rat0mu/2026-Rocket-Taiwan-Cup/avionics/hardware/pcb/台灣盃航電艙第2層_通訊/production/bom.csv

Designator | Footprint | Quantity | Value | LCSC Part #
BT1 | BatteryHolder_Keystone_3000_1x12mm | 1 | Coin_Cell
C1 | 0201 | 1 | 100n
C12, C15, C2, C3 | 0603 | 4 | 100n
C13, C9 | 0402 | 2 | NC
C14 | 0805 | 1 | 10u
C22, C24 | 0402 | 2 | 100n
C23, C25 | 0603 | 2 | 10u
C4 | 0603 | 1 | 1u
C5 | 0201 | 1 | 47p
C6 | 0201 | 1 | 1u
D1 | D_SOD-123 | 1 | 0.5A/40V/420mV
FB1 | 0603 | 1 | FerriteBead
J1, J2 | SMA_Amphenol_132134-11_Vertical | 2 | SMA
R1, R2, R3, R4 | 0603 | 4 | 4.7k
R5 | 0603 | 1 | 100k
R6 | 0603 | 1 | 1k
R7 | 0603 | 1 | 33R
R8 | 0402 | 1 | 0
R9 | 0603 | 1 | 10k
TP1 | TestPoint_Pad_1.0x1.0mm | 1 | Test Point
U1 | LGA-12_2x2mm_P0.5mm | 1 | LIS3MDL
U2 | ublox_NEO | 1 | NEO-M9N
U3 | PE22-230T22S | 1 | E22-900T22S
U5 | PinHeader_2x20_P2.54mm_Vertical | 1 | Connector
