rat0mu/2026-Rocket-Taiwan-Cup/avionics/hardware/pcb/台灣盃航電艙第3層_主系統/production/bom.csv

Designator | Footprint | Quantity | Value | LCSC Part #
C1, C2 | 0603 | 2 | 18p
C10, C11, C12, C13, C14, C15, C16, C17, C19, C20, C21, C22, C25, C28, C4, C5, C8 | 0603 | 17 | 100n
C18, C29 | 0805 | 2 | 10u
C3, C9 | 0603 | 2 | 1u
C30, C32 | 0402 | 2 | 100n
C31, C33 | 0603 | 2 | 10u
C6, C7 | 0805 | 2 | 2.2u
D1 | 0805 | 1 | LED
FB1 | 0603 | 1 | bead
J1 | JST_XH_S2B-XH-A_1x02_P2.50mm_Horizontal | 1 | ~
J2 | microSD_HC_Hirose_DM3D-SF | 1 | Micro_SD_Card_Det2
J3 | PinHeader_1x04_P2.54mm_Horizontal | 1 | Conn_01x04_Pin
R1 | 0603 | 1 | 0
R2, R3, R5, R6, R7, R8, R9 | 0603 | 7 | 10k
R4 | 0805 | 1 | 510
SW1 | SW_SPST_FSMSM | 1 | SW_SPST
U1 | LQFP-100_14x14mm_P0.5mm | 1 | STM32F405VGT6
U11 | PinHeader_2x20_P2.54mm_Vertical | 1 | Connector
U2 | PQFN50P450X300X100-16N | 1 | BMI088
U3 | XDCR_BMP390L | 1 | BMP388
U5 | QFN300X300X100-16N | 1 | H3LIS331DL
Y1 | Crystal_SMD_3225-4Pin_3.2x2.5mm | 1 | 16MHz
