rat0mu/2026-Rocket-Taiwan-Cup/avionics/hardware/pcb/台灣盃航電艙第4層_供電/production/bom.csv

Designator | Footprint | Quantity | Value | LCSC Part #
C1, C2 | CP_Elec_10x10 | 2 | 680u
C10, C5, C6, C9 | 0805 | 4 | 10u
C11, C12, C7, C8 | 0603 | 4 | 100n
C3, C4 | CP_Elec_8x10 | 2 | 220u
D1, D2 | D_SMC | 2 | 1N5824
D3, D4 | 0805 | 2 | LED
D5 | D_SOD-123 | 1 | D_M1
D6 | D_SOD-123 | 1 | D_B1
D7 | D_SOD-123 | 1 | D_M2
D8 | D_SOD-123 | 1 | D_B2
J1, J2 | AMASS_XT60PW-M_1x02_P7.20mm_Horizontal | 2 | XT60
J3 | JST_XH_S6B-XH-A_1x06_P2.50mm_Horizontal | 1 | Conn_01x06_Pin
L1, L2 | L_APV_ANR6045 | 2 | 33u
PYRO1 | JST_XH_S2B-XH-A_1x02_P2.50mm_Horizontal | 1 | Pyro1
PYRO2 | JST_XH_S2B-XH-A_1x02_P2.50mm_Horizontal | 1 | Pyro2
Q1, Q2, Q3, Q4 | SOT-223 | 4 | NMOS
R10, R11, R13, R14 | 0805 | 4 | 220
R12, R15 | 0805 | 2 | 2.2k
U11 | PinHeader_2x20_P2.54mm_Vertical | 1 | Connector
U3, U4 | TO-263-5_TabPin3 | 2 | LM2596S-5
U5, U6 | SOT-223-3_TabPin2 | 2 | AMS1117-3.3
