rat0mu/2026-Rocket-Taiwan-Cup/avionics/hardware/pcb/台灣盃航電艙第5層_次系統/production/bom.csv

Designator | Footprint | Quantity | Value | LCSC Part #
BT1 | BatteryHolder_Keystone_3000_1x12mm | 1 | Coin_Cell
C1, C2 | 0201 | 2 | 12p
C10, C12, C13, C19, C22, C6 | 0603 | 6 | 100n
C11 | 0603 | 1 | 10u
C16 | 0201 | 1 | 47p
C17 | 0201 | 1 | 1u
C18, C20 | 0402 | 2 | NC
C21 | 0805 | 1 | 10u
C23, C4, C5, C7, C8 | 0402 | 5 | 100n
C3 | 0603 | 1 | 1u
C9 | 0201 | 1 | 100n
D1 | 0201 | 1 | LED
D2 | D_SOD-123 | 1 | 0.5A/40V/420mV
FB1 | 0603 | 1 | FerriteBead
J1 | JST_XH_S2B-XH-A_1x02_P2.50mm_Horizontal | 1 | SH 1.0
J2 | microSD_HC_Hirose_DM3D-SF | 1 | Micro_SD_Card
J3, J4 | SMA_Amphenol_132134-11_Vertical | 2 | SMA
J5 | PinHeader_1x04_P2.54mm_Horizontal | 1 | Conn_01x04_Pin
J6 | JST_XH_S6B-XH-A_1x06_P2.50mm_Horizontal | 1 | Conn_01x06_Pin
R1 | 0603 | 1 | 0
R10 | 0603 | 1 | 33R
R11 | 0402 | 1 | 0
R12, R2 | 0603 | 2 | 10k
R3 | 0603 | 1 | 510
R4, R5, R6, R7 | 0603 | 4 | 4.7k
R8 | 0603 | 1 | 100k
R9 | 0603 | 1 | 1k
SW2 | SW_SPST_FSMSM | 1 | SW_SPST
TP1 | TestPoint_Pad_1.0x1.0mm | 1 | Test Point
U1 | LQFP-48_7x7mm_P0.5mm | 1 | STM32F103C8Tx
U2 | XDCR_BMP390L | 1 | BMP390L
U3 | ublox_NEO | 1 | NEO-M9N
U6 | PE22-230T22S | 1 | E22-400T22S
Y1 | Crystal_SMD_3225-4Pin_3.2x2.5mm | 1 | 8MHz
