rat0mu/2026-Rocket-Taiwan-Cup/avionics/hardware/pcb/台灣盃航電艙第1層_聲學實驗/production/First_Layer_bom.csv

Designator | Footprint | Quantity | Value | LCSC Part #
C1 | 0603 | 1 | 2.2u
C10 | 0402 | 1 | 220p
C11 | 0603 | 1 | 4.7u
C12, C14, C16, C17, C19, C2, C20, C22, C23, C25 | 0402 | 10 | 0.1u
C13 | 0805 | 1 | 22u
C15, C7, C8, C9 | 0603 | 4 | 10u
C18, C21, C24, C6 | 0402 | 4 | 1u
C3, C4, C5 | 0402 | 3 | 100n
D1 | D_SOD-123 | 1 | MBR0520
FB1 | 0603 | 1 | FerriteBead
L1 | 1206 | 1 | 10u
R1, R5, R6, R7 | 0603 | 4 | 2k
R2 | 0603 | 1 | 51K
R3 | 0603 | 1 | 24.9K
R4 | 0603 | 1 | 178K
U1, U4, U7, U9 | XDCR_MPXV2202DPT1 | 4 | MPXV2202DPT1
U10, U2, U6, U8 | VSSOP-8_3x3mm_P0.65mm | 4 | INA333xxDGK
U3 | SOT-23-5 | 1 | LM2733YMF
U5 | PinHeader_2x20_P2.54mm_Vertical | 1 | Connector
