rat0mu/2026-Rocket-Taiwan-Cup/structure/cad/airframe/avionics_bay/avionic_bay.SLDASM

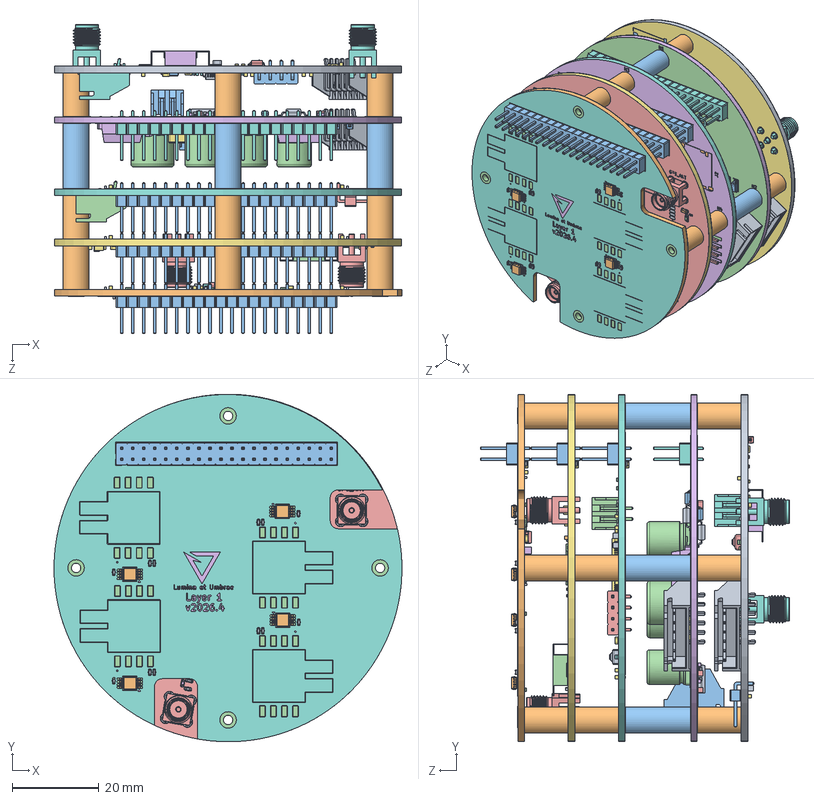
[picture p1: CAD file, 2026-05-14]
structure/cad/airframe/avionics_bay/avionic_bay.SLDASM
80.1 x 80.0 x 71.2 mm
C_0402_1005Metric x 24
VSSOP-8_3x3mm_P0.65mm x 4
PinHeader_2x20_P2.54mm_Vertical x 3
R_0603_1608Metric x 22
SOT-23-5
L_1206_3216Metric
C_0603_1608Metric x 37
D_SOD-123 x 2
C_0805_2012Metric x 6
L_0603_1608Metric x 3
疇_簞癟_瞿癟__癡_穠矇_罈疇__矇_竅癡翹_疇簣瞻_copper
疇_簞癟_瞿癟__癡_穠矇_罈疇__矇_竅癡翹_疇簣瞻_pad
疇_簞癟_瞿癟__癡_穠矇_罈疇__矇_竅癡翹_疇簣瞻_via
疇_簞癟_瞿癟__癡_穠矇_罈疇__矇_竅癡翹_疇簣瞻_silkscreen
疇_簞癟_瞿癟__癡_穠矇_罈疇__矇_竅癡翹_疇簣瞻_silkscreen_2
疇_簞癟_瞿癟__癡_穠矇_罈疇__矇_竅癡翹_疇簣瞻_soldermask
疇_簞癟_瞿癟__癡_穠矇_罈疇__矇_竅癡翹_疇簣瞻_soldermask_2
疇_簞癟_瞿癟__癡_穠矇_罈疇__矇_竅癡翹_疇簣瞻_PCB
C_0201_0603Metric x 3
BatteryHolder_Keystone_3000_1x12mm
SMA_Amphenol_132134-11_Vertical x 2
R_0402_1005Metric
LGA-12_2x2mm_P0.5mm
疇_簞癟_瞿癟__癡_穠矇_罈疇__瓣繡_疇簣瞻_copper
疇_簞癟_瞿癟__癡_穠矇_罈疇__瓣繡_疇簣瞻_pad
疇_簞癟_瞿癟__癡_穠矇_罈疇__瓣繡_疇簣瞻_via
疇_簞癟_瞿癟__癡_穠矇_罈疇__瓣繡_疇簣瞻_silkscreen
疇_簞癟_瞿癟__癡_穠矇_罈疇__瓣繡_疇簣瞻_silkscreen_2
疇_簞癟_瞿癟__癡_穠矇_罈疇__瓣繡_疇簣瞻_soldermask
疇_簞癟_瞿癟__癡_穠矇_罈疇__瓣繡_疇簣瞻_soldermask_2
疇_簞癟_瞿癟__癡_穠矇_罈疇__瓣繡_疇簣瞻_PCB
pines
cuerpo
boton
R_0805_2012Metric
JST_XH_S2B-XH-A_1x02_P2.50mm_Horizontal
PinHeader_1x04_P2.54mm_Horizontal
Crystal_SMD_3225-4Pin_3.2x2.5mm
LQFP-100_14x14mm_P0.5mm
LED_0805_2012Metric
疇_簞癟_瞿癟__癡_穠矇_罈癡__瓣繡簫疇簣瞻_copper
疇_簞癟_瞿癟__癡_穠矇_罈癡__瓣繡簫疇簣瞻_pad
疇_簞癟_瞿癟__癡_穠矇_罈癡__瓣繡簫疇簣瞻_via
疇_簞癟_瞿癟__癡_穠矇_罈癡__瓣繡簫疇簣瞻_silkscreen
疇_簞癟_瞿癟__癡_穠矇_罈癡__瓣繡簫疇簣瞻_silkscreen_2
疇_簞癟_瞿癟__癡_穠矇_罈癡__瓣繡簫疇簣瞻_soldermask
疇_簞癟_瞿癟__癡_穠矇_罈癡__瓣繡簫疇簣瞻_soldermask_2
疇_簞癟_瞿癟__癡_穠矇_罈癡__瓣繡簫疇簣瞻_PCB
複製 of SOT-223^台灣盃航電倉下層 x 6
複製 of R_0805_2012Metric^台灣盃航電倉下層 x 6
複製 of D_SOD-123^台灣盃航電倉下層 x 4
複製 of CP_Elec_10x10^台灣盃航電倉下層 x 2
複製 of D_SMC^台灣盃航電倉下層 x 2
複製 of ________ 1.10.1^複製 of TO-263-5_TabPin3_台灣盃航電倉下層 x 2
複製 of L_APV_ANR6045^台灣盃航電倉下層 x 2
複製 of PinHeader_2x20_P2.54mm_Vertical^台灣盃航電倉下層
複製 of JST_XH_S6B-XH-A_1x06_P2.50mm_Horizontal^台灣盃航電倉下層
複製 of LED_0805_2012Metric^台灣盃航電倉下層 x 2
複製 of JST_XH_S2B-XH-A_1x02_P2.50mm_Horizontal^台灣盃航電倉下層 x 2
複製 of CP_Elec_8x10^台灣盃航電倉下層 x 2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
