rat0mu/2026-Rocket-Taiwan-Cup/structure/cad/airframe/avionics_bay/cylinder15mm.SLDPRT

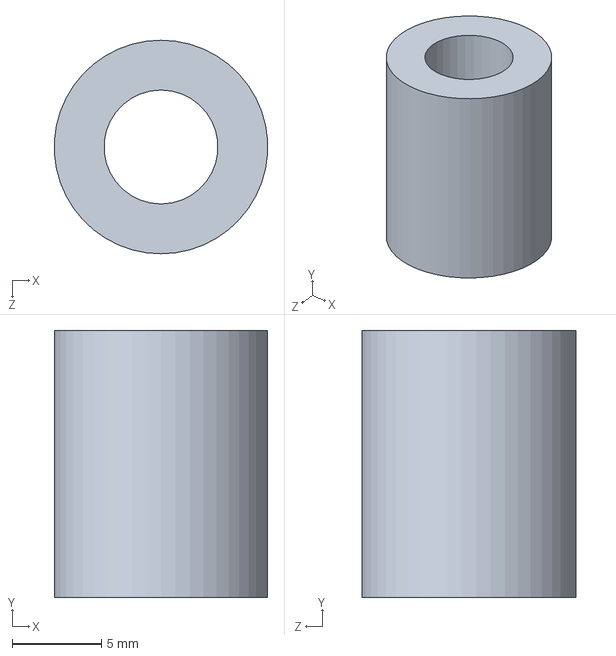
[picture p2: CAD file, 2026-05-14]
structure/cad/airframe/avionics_bay/cylinder15mm.SLDPRT
12.0 x 15.0 x 12.0 mm
