rat0mu/2026-Rocket-Taiwan-Cup/structure/cad/airframe/avionics_bay/support cylinder.SLDPRT

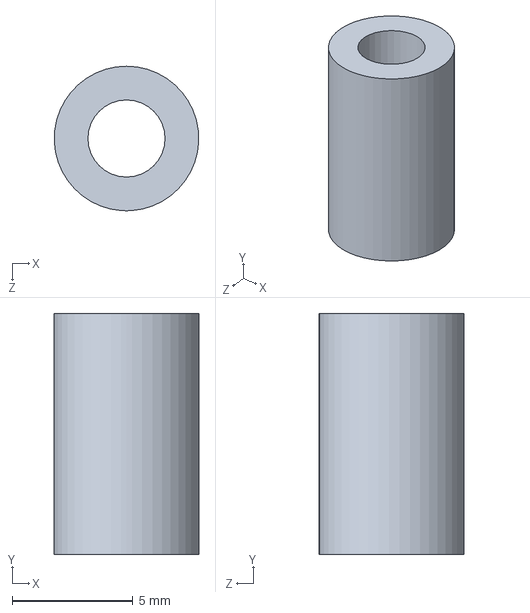
[picture p3: CAD file, 2026-05-14]
structure/cad/airframe/avionics_bay/support cylinder.SLDPRT
6.00 x 10.0 x 6.00 mm
