rat0mu/2026-Rocket-Taiwan-Cup/structure/cad/airframe/avionics_bay/台灣盃航電倉酬載層/台灣盃航電倉酬載層.step

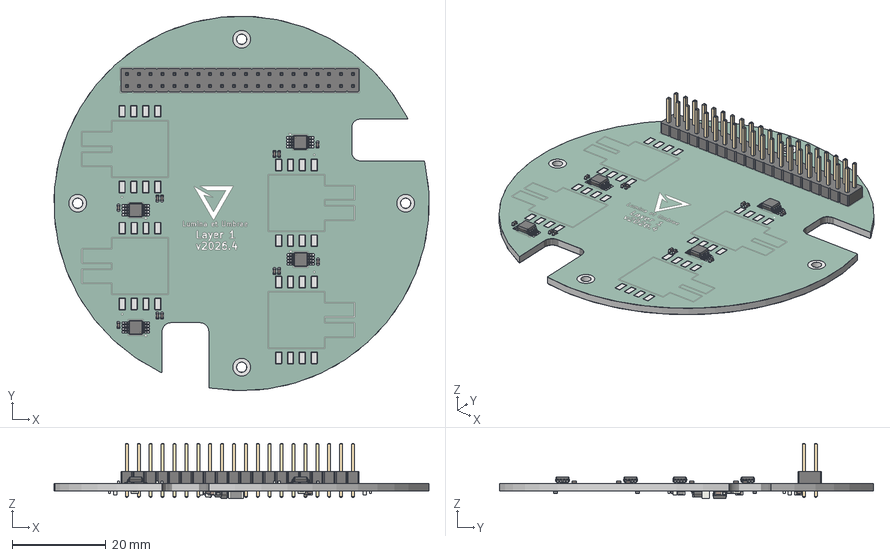
[picture p4: CAD file, 2026-05-14]
structure/cad/airframe/avionics_bay/台灣盃航電倉酬載層/台灣盃航電倉酬載層.step
80.0 x 79.9 x 11.8 mm
C_0402_1005Metric x 18
VSSOP-8_3x3mm_P0.65mm x 4
PinHeader_2x20_P2.54mm_Vertical
R_0603_1608Metric x 7
SOT-23-5
L_1206_3216Metric
C_0603_1608Metric x 6
D_SOD-123
C_0805_2012Metric
L_0603_1608Metric
å°ç£çèªé»åé ¬è¼å±¤_copper
å°ç£çèªé»åé ¬è¼å±¤_pad
å°ç£çèªé»åé ¬è¼å±¤_via
å°ç£çèªé»åé ¬è¼å±¤_silkscreen x 2
å°ç£çèªé»åé ¬è¼å±¤_soldermask x 2
å°ç£çèªé»åé ¬è¼å±¤_PCB
