rat0mu/2026-Rocket-Taiwan-Cup/structure/cad/airframe/avionics_bay/台灣盃航電倉次系統/台灣盃航電倉次系統.step

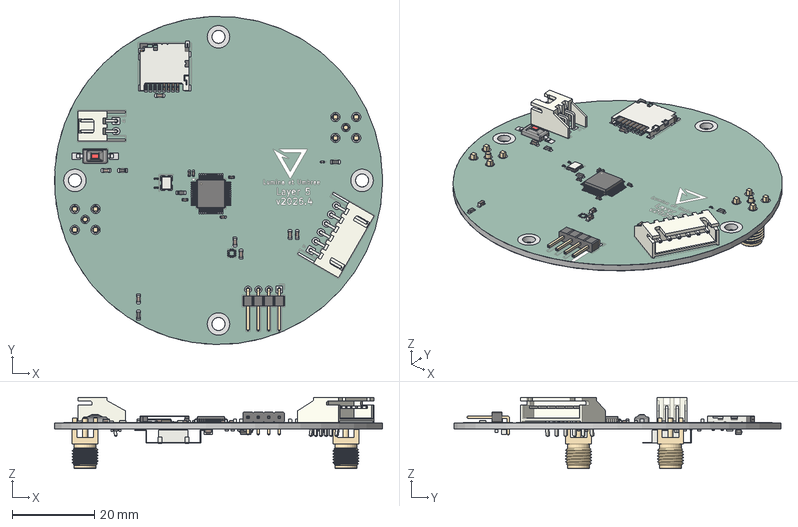
[picture p5: CAD file, 2026-05-14]
structure/cad/airframe/avionics_bay/台灣盃航電倉次系統/台灣盃航電倉次系統.step
80.0 x 80.0 x 17.3 mm
C_0603_1608Metric x 8
C_0402_1005Metric x 7
JST_XH_S6B-XH-A_1x06_P2.50mm_Horizontal
C_0201_0603Metric x 5
Crystal_SMD_3225-4Pin_3.2x2.5mm
pines
cuerpo
boton
R_0603_1608Metric x 11
JST_XH_S2B-XH-A_1x02_P2.50mm_Horizontal
LQFP-48_7x7mm_P0.5mm
microSD_HC_Hirose_DM3D-SF
LED_0201_0603Metric
PinHeader_1x04_P2.54mm_Horizontal
R_0402_1005Metric
D_SOD-123
BatteryHolder_Keystone_3000_1x12mm
L_0603_1608Metric
SMA_Amphenol_132134-11_Vertical x 2
C_0805_2012Metric
å°ç£çèªé»åæ¬¡ç³»çµ±_copper
å°ç£çèªé»åæ¬¡ç³»çµ±_pad
å°ç£çèªé»åæ¬¡ç³»çµ±_via
å°ç£çèªé»åæ¬¡ç³»çµ±_silkscreen x 2
å°ç£çèªé»åæ¬¡ç³»çµ±_soldermask x 2
å°ç£çèªé»åæ¬¡ç³»çµ±_PCB
