rat0mu/2026-Rocket-Taiwan-Cup/structure/cad/airframe/avionics_bay/台灣盃航電艙中層/台灣盃航電艙中層.step

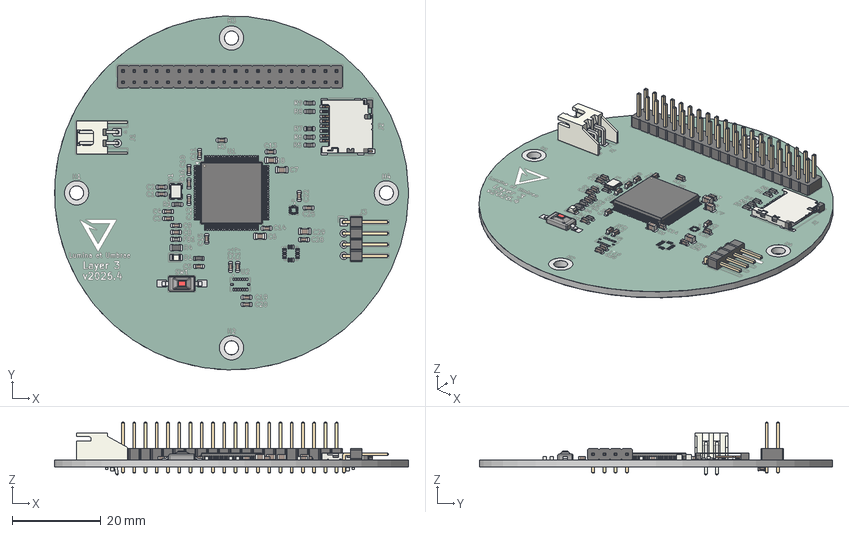
[picture p6: CAD file, 2026-05-14]
structure/cad/airframe/avionics_bay/台灣盃航電艙中層/台灣盃航電艙中層.step
80.0 x 80.0 x 11.9 mm
microSD_HC_Hirose_DM3D-SF
C_0603_1608Metric x 24
C_0805_2012Metric x 4
R_0603_1608Metric x 7
pines
cuerpo
boton
R_0805_2012Metric
JST_XH_S2B-XH-A_1x02_P2.50mm_Horizontal
PinHeader_1x04_P2.54mm_Horizontal
Crystal_SMD_3225-4Pin_3.2x2.5mm
L_0603_1608Metric
PinHeader_2x20_P2.54mm_Vertical
LQFP-100_14x14mm_P0.5mm
LED_0805_2012Metric
C_0402_1005Metric x 2
å°ç£çèªé»èä¸å±¤_copper
å°ç£çèªé»èä¸å±¤_pad
å°ç£çèªé»èä¸å±¤_via
å°ç£çèªé»èä¸å±¤_silkscreen x 2
å°ç£çèªé»èä¸å±¤_soldermask x 2
å°ç£çèªé»èä¸å±¤_PCB
