rat0mu/2026-Rocket-Taiwan-Cup/structure/cad/airframe/avionics_bay/台灣盃航電倉上層/台灣盃航電倉上層.step

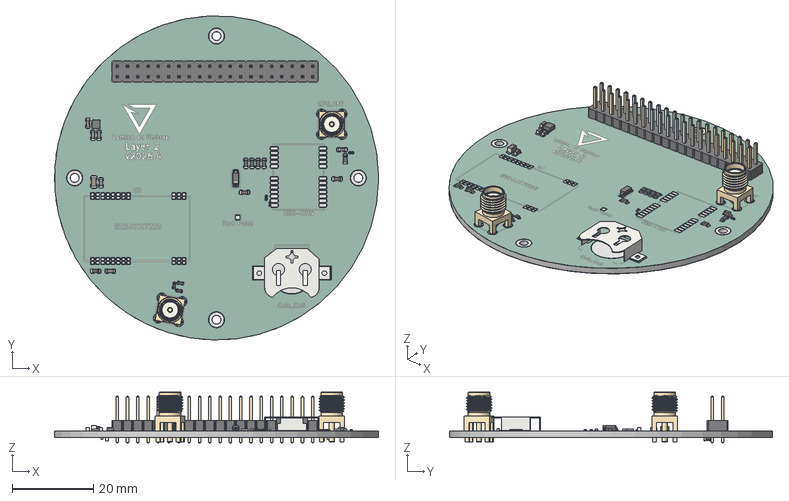
[picture p7: CAD file, 2026-05-14]
structure/cad/airframe/avionics_bay/台灣盃航電倉上層/台灣盃航電倉上層.step
80.0 x 80.0 x 12.6 mm
C_0201_0603Metric x 3
C_0603_1608Metric x 7
C_0402_1005Metric x 4
R_0603_1608Metric x 8
BatteryHolder_Keystone_3000_1x12mm
SMA_Amphenol_132134-11_Vertical x 2
L_0603_1608Metric
R_0402_1005Metric
LGA-12_2x2mm_P0.5mm
C_0805_2012Metric
PinHeader_2x20_P2.54mm_Vertical
D_SOD-123
å°ç£çèªé»åä¸å±¤_copper
å°ç£çèªé»åä¸å±¤_pad
å°ç£çèªé»åä¸å±¤_via
å°ç£çèªé»åä¸å±¤_silkscreen x 2
å°ç£çèªé»åä¸å±¤_soldermask x 2
å°ç£çèªé»åä¸å±¤_PCB
