rat0mu/2026-Rocket-Taiwan-Cup/structure/cad/airframe/avionics_bay/台灣盃航電倉下層/台灣盃航電倉下層.step

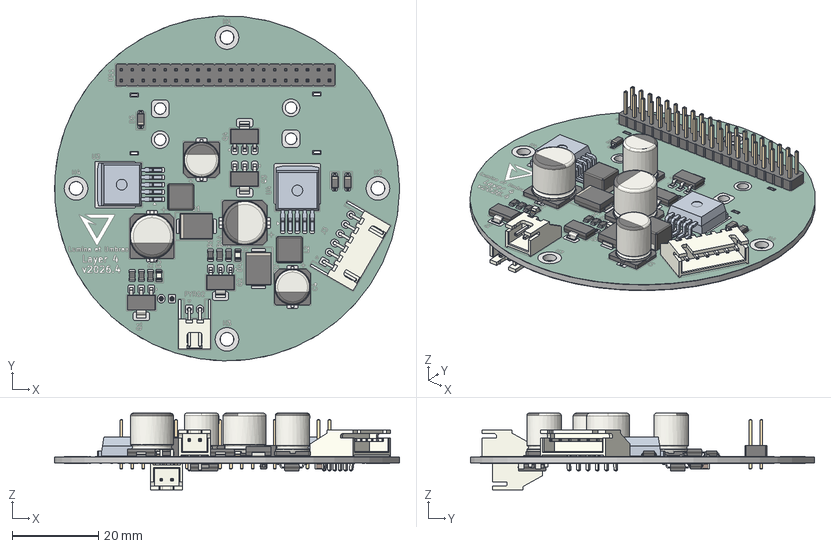
[picture p8: CAD file, 2026-05-14]
structure/cad/airframe/avionics_bay/台灣盃航電倉下層/台灣盃航電倉下層.step
80.0 x 80.0 x 17.8 mm
SOT-223 x 6
R_0805_2012Metric x 6
D_SOD-123 x 4
CP_Elec_10x10 x 2
D_SMC x 2
L_APV_ANR6045 x 2
PinHeader_2x20_P2.54mm_Vertical
JST_XH_S6B-XH-A_1x06_P2.50mm_Horizontal
LED_0805_2012Metric x 2
JST_XH_S2B-XH-A_1x02_P2.50mm_Horizontal x 2
CP_Elec_8x10 x 2
C_0805_2012Metric x 4
C_0603_1608Metric x 4
å°ç£çèªé»åä¸å±¤_copper
å°ç£çèªé»åä¸å±¤_pad
å°ç£çèªé»åä¸å±¤_via
å°ç£çèªé»åä¸å±¤_silkscreen x 2
å°ç£çèªé»åä¸å±¤_soldermask x 2
å°ç£çèªé»åä¸å±¤_PCB
