rat0mu/2026-Rocket-Taiwan-Cup/(list of files, cad)

Other CAD files:
structure/cad/airframe/avionics_bay/台灣盃航電倉下層/TO-263-5_TabPin3.sldasm
structure/cad/airframe/avionics_bay/台灣盃航電艙中層/SW_SPST_FSMSM.sldasm
structure/cad/airframe/avionics_bay/台灣盃航電倉次系統/SW_SPST_FSMSM.sldasm
structure/cad/airframe/avionics_bay/台灣盃航電倉上層/PinHeader_2x20_P2.54mm_Vertical.sldprt
structure/cad/airframe/avionics_bay/台灣盃航電倉下層/疇_簞癟_瞿癟__癡_穠矇_罈疇__瓣繡_疇簣瞻_pad.sldprt
structure/cad/airframe/avionics_bay/台灣盃航電倉次系統/D_SOD-123.sldprt
structure/cad/airframe/avionics_bay/台灣盃航電倉酬載層/VSSOP-8_3x3mm_P0.65mm.sldprt
structure/cad/airframe/avionics_bay/台灣盃航電艙中層/LQFP-100_14x14mm_P0.5mm.sldprt
structure/cad/airframe/avionics_bay/台灣盃航電倉上層/疇_簞癟_瞿癟__癡_穠矇_罈疇__瓣繡_疇簣瞻_copper.sldprt
structure/cad/airframe/avionics_bay/台灣盃航電倉下層/疇_簞癟_瞿癟__癡_穠矇_罈疇__瓣繡_疇簣瞻_via.sldprt
structure/cad/airframe/avionics_bay/台灣盃航電倉次系統/C_0805_2012Metric.sldprt
structure/cad/airframe/avionics_bay/台灣盃航電倉酬載層/疇_簞癟_瞿癟__癡_穠矇_罈疇__矇_竅癡翹_疇簣瞻_soldermask_2.sldprt
structure/cad/airframe/avionics_bay/台灣盃航電艙中層/C_0805_2012Metric.sldprt
structure/cad/airframe/avionics_bay/台灣盃航電倉上層/D_SOD-123.sldprt
structure/cad/airframe/avionics_bay/台灣盃航電倉下層/疇_簞癟_瞿癟__癡_穠矇_罈疇__瓣繡_疇簣瞻_copper.sldprt
structure/cad/airframe/avionics_bay/台灣盃航電倉次系統/疇_簞癟_瞿癟__癡_穠矇_罈疇__疆竅癒癟糧罈癟繕簣_silkscreen.sldprt
structure/cad/airframe/avionics_bay/台灣盃航電倉酬載層/SOT-23-5.sldprt
structure/cad/airframe/avionics_bay/台灣盃航電艙中層/PinHeader_1x04_P2.54mm_Horizontal.sldprt
structure/cad/airframe/avionics_bay/台灣盃航電倉上層/疇_簞癟_瞿癟__癡_穠矇_罈疇__瓣繡_疇簣瞻_soldermask.sldprt
structure/cad/airframe/avionics_bay/台灣盃航電倉次系統/C_0402_1005Metric.sldprt
structure/cad/airframe/avionics_bay/台灣盃航電倉酬載層/C_0603_1608Metric.sldprt
structure/cad/airframe/avionics_bay/台灣盃航電艙中層/boton.sldprt
structure/cad/airframe/avionics_bay/台灣盃航電倉上層/疇_簞癟_瞿癟__癡_穠矇_罈疇__瓣繡_疇簣瞻_via.sldprt
structure/cad/airframe/avionics_bay/台灣盃航電倉下層/CP_Elec_8x10.sldprt
structure/cad/airframe/avionics_bay/台灣盃航電倉次系統/SMA_Amphenol_132134-11_Vertical.sldprt
structure/cad/airframe/avionics_bay/台灣盃航電倉酬載層/疇_簞癟_瞿癟__癡_穠矇_罈疇__矇_竅癡翹_疇簣瞻_soldermask.sldprt
structure/cad/airframe/avionics_bay/台灣盃航電艙中層/PinHeader_2x20_P2.54mm_Vertical.sldprt
structure/cad/airframe/avionics_bay/台灣盃航電倉上層/C_0201_0603Metric.sldprt
structure/cad/airframe/avionics_bay/台灣盃航電倉下層/R_0805_2012Metric.sldprt
structure/cad/airframe/avionics_bay/台灣盃航電倉次系統/PinHeader_1x04_P2.54mm_Horizontal.sldprt
structure/cad/airframe/avionics_bay/台灣盃航電倉酬載層/疇_簞癟_瞿癟__癡_穠矇_罈疇__矇_竅癡翹_疇簣瞻_pad.sldprt
structure/cad/airframe/avionics_bay/台灣盃航電艙中層/疇_簞癟_瞿癟__癡_穠矇_罈癡__瓣繡簫疇簣瞻_silkscreen.sldprt
structure/cad/airframe/avionics_bay/台灣盃航電倉上層/SMA_Amphenol_132134-11_Vertical.sldprt
structure/cad/airframe/avionics_bay/台灣盃航電倉下層/C_0805_2012Metric.sldprt
structure/cad/airframe/avionics_bay/台灣盃航電倉次系統/R_0603_1608Metric.sldprt
structure/cad/airframe/avionics_bay/台灣盃航電倉酬載層/疇_簞癟_瞿癟__癡_穠矇_罈疇__矇_竅癡翹_疇簣瞻_PCB.sldprt
structure/cad/airframe/avionics_bay/台灣盃航電艙中層/pines.sldprt
structure/cad/airframe/avionics_bay/台灣盃航電倉上層/L_0603_1608Metric.sldprt
structure/cad/airframe/avionics_bay/台灣盃航電倉下層/C_0603_1608Metric.sldprt
structure/cad/airframe/avionics_bay/台灣盃航電倉次系統/C_0603_1608Metric.sldprt
structure/cad/airframe/avionics_bay/台灣盃航電倉酬載層/D_SOD-123.sldprt
structure/cad/airframe/avionics_bay/台灣盃航電艙中層/cuerpo.sldprt
structure/cad/airframe/avionics_bay/台灣盃航電倉上層/疇_簞癟_瞿癟__癡_穠矇_罈疇__瓣繡_疇簣瞻_silkscreen_2.sldprt
structure/cad/airframe/avionics_bay/台灣盃航電倉下層/D_SMC.sldprt
structure/cad/airframe/avionics_bay/台灣盃航電倉次系統/BatteryHolder_Keystone_3000_1x12mm.sldprt
structure/cad/airframe/avionics_bay/台灣盃航電倉酬載層/疇_簞癟_瞿癟__癡_穠矇_罈疇__矇_竅癡翹_疇簣瞻_via.sldprt
structure/cad/airframe/avionics_bay/台灣盃航電艙中層/LED_0805_2012Metric.sldprt
structure/cad/airframe/avionics_bay/台灣盃航電倉上層/LGA-12_2x2mm_P0.5mm.sldprt
structure/cad/airframe/avionics_bay/台灣盃航電倉下層/SOT-223.sldprt
structure/cad/airframe/avionics_bay/台灣盃航電倉次系統/疇_簞癟_瞿癟__癡_穠矇_罈疇__疆竅癒癟糧罈癟繕簣_silkscreen_2.sldprt
structure/cad/airframe/avionics_bay/台灣盃航電艙中層/疇_簞癟_瞿癟__癡_穠矇_罈癡__瓣繡簫疇簣瞻_pad.sldprt
structure/cad/airframe/avionics_bay/台灣盃航電倉上層/R_0402_1005Metric.sldprt
structure/cad/airframe/avionics_bay/台灣盃航電倉下層/JST_XH_S6B-XH-A_1x06_P2.50mm_Horizontal.sldprt
structure/cad/airframe/avionics_bay/台灣盃航電倉次系統/L_0603_1608Metric.sldprt
structure/cad/airframe/avionics_bay/台灣盃航電倉酬載層/疇_簞癟_瞿癟__癡_穠矇_罈疇__矇_竅癡翹_疇簣瞻_silkscreen.sldprt
structure/cad/airframe/avionics_bay/台灣盃航電艙中層/疇_簞癟_瞿癟__癡_穠矇_罈癡__瓣繡簫疇簣瞻_soldermask_2.sldprt
structure/cad/airframe/avionics_bay/台灣盃航電倉上層/C_0603_1608Metric.sldprt
structure/cad/airframe/avionics_bay/台灣盃航電倉下層/________ 1.10.1.sldprt
structure/cad/airframe/avionics_bay/台灣盃航電倉次系統/cuerpo.sldprt
structure/cad/airframe/avionics_bay/台灣盃航電倉酬載層/L_1206_3216Metric.sldprt
structure/cad/airframe/avionics_bay/台灣盃航電艙中層/C_0402_1005Metric.sldprt
structure/cad/airframe/avionics_bay/台灣盃航電倉上層/疇_簞癟_瞿癟__癡_穠矇_罈疇__瓣繡_疇簣瞻_PCB.sldprt
structure/cad/airframe/avionics_bay/台灣盃航電倉下層/疇_簞癟_瞿癟__癡_穠矇_罈疇__瓣繡_疇簣瞻_silkscreen_2.sldprt
structure/cad/airframe/avionics_bay/台灣盃航電倉次系統/boton.sldprt
structure/cad/airframe/avionics_bay/台灣盃航電倉酬載層/C_0402_1005Metric.sldprt
structure/cad/airframe/avionics_bay/台灣盃航電倉上層/疇_簞癟_瞿癟__癡_穠矇_罈疇__瓣繡_疇簣瞻_silkscreen.sldprt
structure/cad/airframe/avionics_bay/台灣盃航電倉下層/D_SOD-123.sldprt
structure/cad/airframe/avionics_bay/台灣盃航電倉酬載層/L_0603_1608Metric.sldprt
structure/cad/airframe/avionics_bay/台灣盃航電艙中層/JST_XH_S2B-XH-A_1x02_P2.50mm_Horizontal.sldprt
structure/cad/airframe/avionics_bay/台灣盃航電倉上層/疇_簞癟_瞿癟__癡_穠矇_罈疇__瓣繡_疇簣瞻_pad.sldprt
structure/cad/airframe/avionics_bay/台灣盃航電倉下層/疇_簞癟_瞿癟__癡_穠矇_罈疇__瓣繡_疇簣瞻_soldermask_2.sldprt
structure/cad/airframe/avionics_bay/台灣盃航電倉次系統/pines.sldprt
structure/cad/airframe/avionics_bay/台灣盃航電倉酬載層/R_0603_1608Metric.sldprt
structure/cad/airframe/avionics_bay/台灣盃航電艙中層/Crystal_SMD_3225-4Pin_3.2x2.5mm.sldprt
structure/cad/airframe/avionics_bay/台灣盃航電倉上層/C_0402_1005Metric.sldprt
structure/cad/airframe/avionics_bay/台灣盃航電倉下層/疇_簞癟_瞿癟__癡_穠矇_罈疇__瓣繡_疇簣瞻_PCB.sldprt
structure/cad/airframe/avionics_bay/台灣盃航電倉次系統/JST_XH_S2B-XH-A_1x02_P2.50mm_Horizontal.sldprt
structure/cad/airframe/avionics_bay/台灣盃航電倉酬載層/PinHeader_2x20_P2.54mm_Vertical.sldprt
structure/cad/airframe/avionics_bay/台灣盃航電倉上層/疇_簞癟_瞿癟__癡_穠矇_罈疇__瓣繡_疇簣瞻_soldermask_2.sldprt
structure/cad/airframe/avionics_bay/台灣盃航電倉下層/疇_簞癟_瞿癟__癡_穠矇_罈疇__瓣繡_疇簣瞻_silkscreen.sldprt
structure/cad/airframe/avionics_bay/台灣盃航電倉次系統/LQFP-48_7x7mm_P0.5mm.sldprt
structure/cad/airframe/avionics_bay/台灣盃航電倉酬載層/C_0805_2012Metric.sldprt
structure/cad/airframe/avionics_bay/台灣盃航電艙中層/R_0603_1608Metric.sldprt
structure/cad/airframe/avionics_bay/台灣盃航電倉上層/R_0603_1608Metric.sldprt
structure/cad/airframe/avionics_bay/台灣盃航電倉下層/LED_0805_2012Metric.sldprt
structure/cad/airframe/avionics_bay/台灣盃航電倉次系統/疇_簞癟_瞿癟__癡_穠矇_罈疇__疆竅癒癟糧罈癟繕簣_pad.sldprt
structure/cad/airframe/avionics_bay/台灣盃航電倉酬載層/疇_簞癟_瞿癟__癡_穠矇_罈疇__矇_竅癡翹_疇簣瞻_copper.sldprt
structure/cad/airframe/avionics_bay/台灣盃航電艙中層/L_0603_1608Metric.sldprt
structure/cad/airframe/avionics_bay/台灣盃航電倉上層/C_0805_2012Metric.sldprt
structure/cad/airframe/avionics_bay/台灣盃航電倉下層/L_APV_ANR6045.sldprt
structure/cad/airframe/avionics_bay/台灣盃航電倉次系統/疇_簞癟_瞿癟__癡_穠矇_罈疇__疆竅癒癟糧罈癟繕簣_PCB.sldprt
structure/cad/airframe/avionics_bay/台灣盃航電倉酬載層/疇_簞癟_瞿癟__癡_穠矇_罈疇__矇_竅癡翹_疇簣瞻_silkscreen_2.sldprt
structure/cad/airframe/avionics_bay/台灣盃航電艙中層/疇_簞癟_瞿癟__癡_穠矇_罈癡__瓣繡簫疇簣瞻_PCB.sldprt
structure/cad/airframe/avionics_bay/台灣盃航電倉下層/CP_Elec_10x10.sldprt
structure/cad/airframe/avionics_bay/台灣盃航電倉次系統/R_0402_1005Metric.sldprt
structure/cad/airframe/avionics_bay/台灣盃航電艙中層/疇_簞癟_瞿癟__癡_穠矇_罈癡__瓣繡簫疇簣瞻_silkscreen_2.sldprt
structure/cad/airframe/avionics_bay/台灣盃航電倉上層/BatteryHolder_Keystone_3000_1x12mm.sldprt
structure/cad/airframe/avionics_bay/台灣盃航電倉下層/PinHeader_2x20_P2.54mm_Vertical.sldprt
structure/cad/airframe/avionics_bay/台灣盃航電倉次系統/C_0201_0603Metric.sldprt
structure/cad/airframe/avionics_bay/台灣盃航電艙中層/R_0805_2012Metric.sldprt
structure/cad/airframe/avionics_bay/台灣盃航電倉下層/JST_XH_S2B-XH-A_1x02_P2.50mm_Horizontal.sldprt
structure/cad/airframe/avionics_bay/台灣盃航電倉次系統/疇_簞癟_瞿癟__癡_穠矇_罈疇__疆竅癒癟糧罈癟繕簣_copper.sldprt
structure/cad/airframe/avionics_bay/台灣盃航電艙中層/疇_簞癟_瞿癟__癡_穠矇_罈癡__瓣繡簫疇簣瞻_via.sldprt
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
