rat0mu/2026-Rocket-Taiwan-Cup/avionics/hardware/pcb/台灣盃航電艙第5層_次系統/台灣盃航電倉次系統.kicad_pcb

## KiCad design avionics/hardware/pcb/台灣盃航電艙第5層_次系統/台灣盃航電倉次系統.kicad_pcb (2026-05-03)

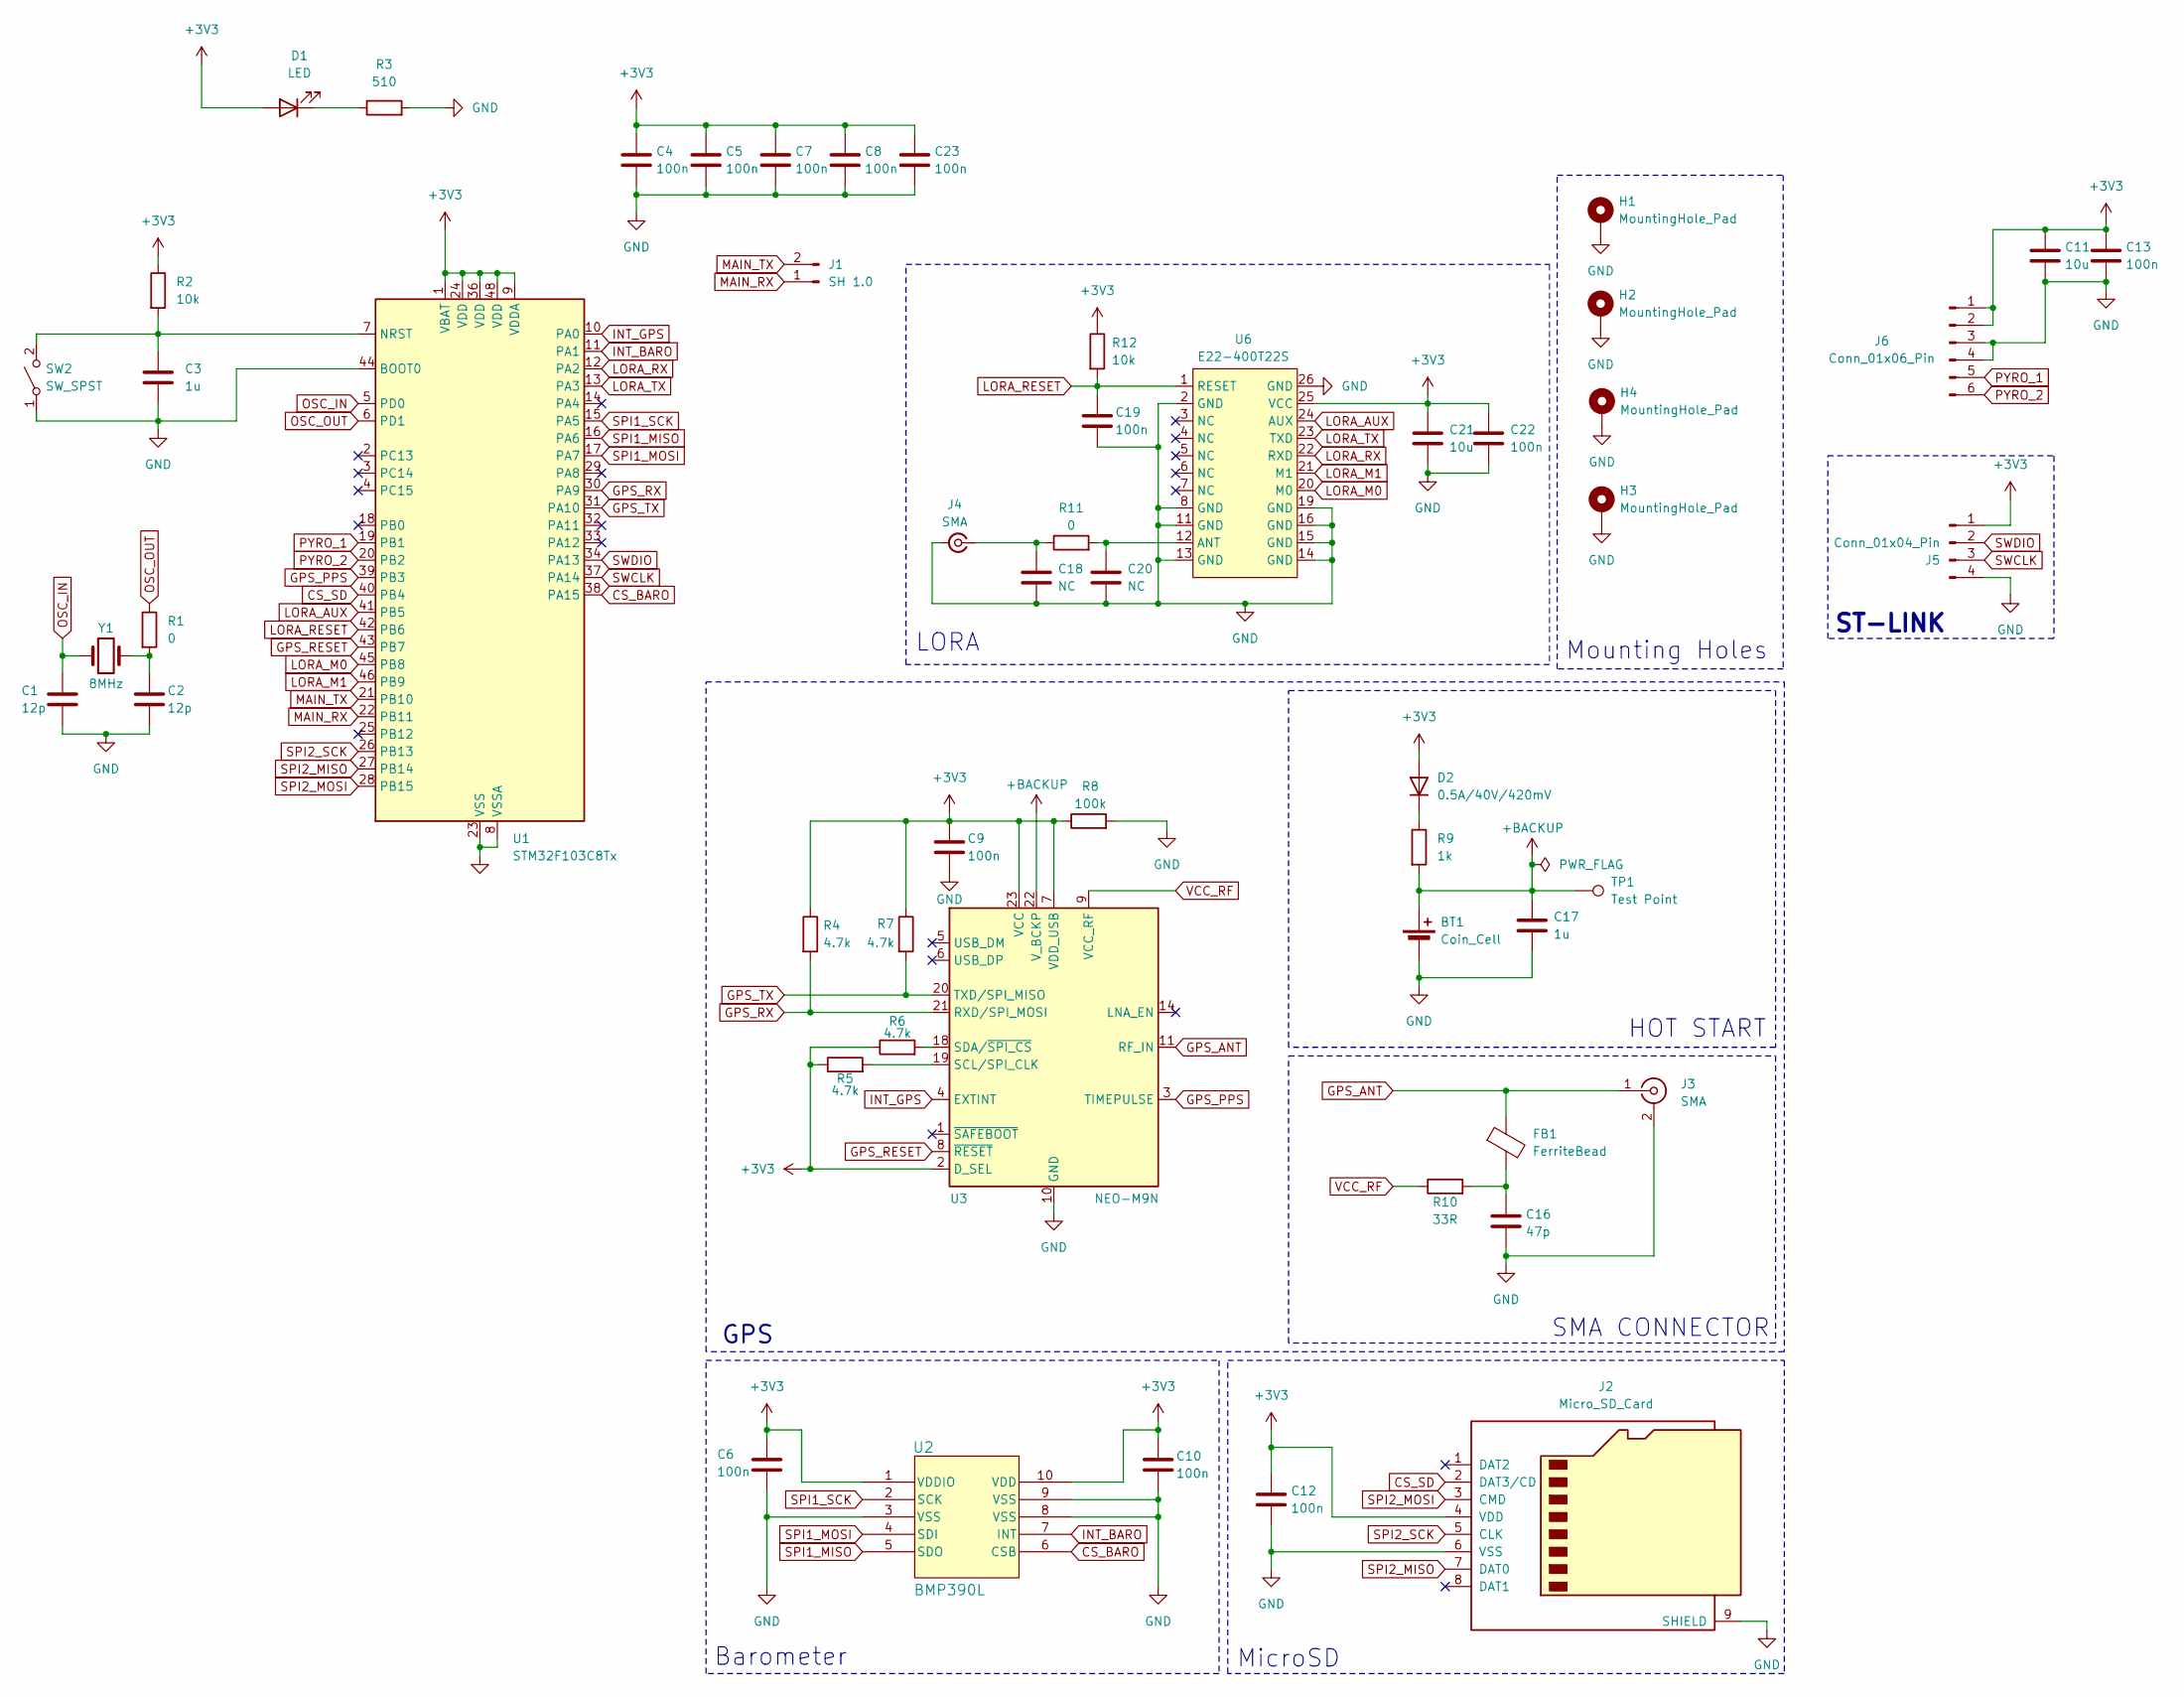
[picture p9: schematic 台灣盃航電倉次系統.kicad_sch]

Parts:
BT1: Coin_Cell; BatteryHolder_Keystone_3000_1x12mm
C1, C2: 12p; C_0201_0603Metric
C3: 1u; C_0603_1608Metric
C4, C5, C7, C8, C23: 100n; C_0402_1005Metric
C6, C10, C12, C13, C19, C22: 100n; C_0603_1608Metric
C9: 100n; C_0201_0603Metric
C11: 10u; C_0603_1608Metric
C16: 47p; C_0201_0603Metric
C17: 1u; C_0201_0603Metric
C18, C20: NC; C_0402_1005Metric
C21: 10u; C_0805_2012Metric
D1: LED; LED_0201_0603Metric
D2: 0.5A/40V/420mV; D_SOD-123
FB1: FerriteBead; L_0603_1608Metric
H1, H2, H3, H4: MountingHole_Pad; MountingHole_3.2mm_M3_ISO14580_Pad
J1: SH 1.0; JST_XH_S2B-XH-A_1x02_P2.50mm_Horizontal
J2: Micro_SD_Card; microSD_HC_Hirose_DM3D-SF
J3, J4: SMA; SMA_Amphenol_132134-11_Vertical
J5: Conn_01x04_Pin; PinHeader_1x04_P2.54mm_Horizontal
J6: Conn_01x06_Pin; JST_XH_S6B-XH-A_1x06_P2.50mm_Horizontal
R1: 0; R_0603_1608Metric
R2, R12: 10k; R_0603_1608Metric
R3: 510; R_0603_1608Metric
R4, R5, R6, R7: 4.7k; R_0603_1608Metric
R8: 100k; R_0603_1608Metric
R9: 1k; R_0603_1608Metric
R10: 33R; R_0603_1608Metric
R11: 0; R_0402_1005Metric
SW2: SW_SPST; SW_SPST_FSMSM
TP1: Test Point; TestPoint_Pad_1.0x1.0mm
U1: STM32F103C8Tx; LQFP-48_7x7mm_P0.5mm
U2: BMP390L; XDCR_BMP390L
U3: NEO-M9N; ublox_NEO
U6: E22-400T22S; PE22-230T22S
Y1: 8MHz; Crystal_SMD_3225-4Pin_3.2x2.5mm

Connections:
+3V3: C4.1, C5.1, C6.1, C7.1, C8.1, C9.1, C10.1, C11.1, C12.1, C13.1, C21.1, C22.1, C23.1, D1.2 (A), D2.2 (A), J2.4 (VDD), J5.1, J6.1, J6.2, R2.1, R4.1, R5.1, R6.1, R7.1, R8.1, R12.1, U1.1 (VBAT), U1.9 (VDDA), U1.24 (VDD), U1.36 (VDD), U1.48 (VDD), U2.1 (VDDIO), U2.10 (VDD), U3.2 (D_SEL), U3.7 (VDD_USB), U3.23 (VCC), U6.25 (VCC)
+BACKUP: BT1.1 (+), C17.1, R9.2, TP1.1, U3.22 (V_BCKP)
CS_BARO: U1.38 (PA15), U2.6 (CSB)
CS_SD: J2.2 (DAT3/CD), U1.40 (PB4)
GND: BT1.2 (-), C1.2, C2.2, C3.2, C4.2, C5.2, C6.2, C7.2, C8.2, C9.2, C10.2, C11.2, C12.2, C13.2, C16.2, C17.2, C18.2, C19.2, C20.2, C21.2, C22.2, C23.2, H1.1, H2.1, H3.1, H4.1, J2.6 (VSS), J2.9 (SHIELD), J3.2 (Ext), J4.2 (Ext), J5.4, J6.3, J6.4, R3.2, R8.2, SW2.1 (A), U1.8 (VSSA), U1.23 (VSS), U1.35 (VSS), U1.44 (BOOT0), U1.47 (VSS), U2.3 (VSS), U2.8 (VSS), U2.9 (VSS), U3.10 (GND), U3.12 (GND), U3.13 (GND), U3.24 (GND), U6.2 (GND), U6.8 (GND), U6.11 (GND), U6.13 (GND), U6.14 (GND), U6.15 (GND), U6.16 (GND), U6.19 (GND), U6.26 (GND)
GPS_ANT: FB1.1, J3.1 (In), U3.11 (RF_IN)
GPS_PPS: U1.39 (PB3), U3.3 (TIMEPULSE)
GPS_RESET: U1.43 (PB7), U3.8 (~RESET)
GPS_RX: R4.2, U1.30 (PA9), U3.21 (RXD/SPI_MOSI)
GPS_TX: R7.2, U1.31 (PA10), U3.20 (TXD/SPI_MISO)
INT_BARO: U1.11 (PA1), U2.7 (INT)
INT_GPS: U1.10 (PA0), U3.4 (EXTINT)
LORA_AUX: U1.41 (PB5), U6.24 (AUX)
LORA_M0: U1.45 (PB8), U6.20 (M0)
LORA_M1: U1.46 (PB9), U6.21 (M1)
LORA_RESET: C19.1, R12.2, U1.42 (PB6), U6.1 (RESET)
LORA_RX: U1.12 (PA2), U6.22 (RXD)
LORA_TX: U1.13 (PA3), U6.23 (TXD)
MAIN_RX: J1.1, U1.22 (PB11)
MAIN_TX: J1.2, U1.21 (PB10)
unnamed: C2.1, R1.2, Y1.2
unnamed: C16.1, FB1.2, R10.2
unnamed: D1.1 (K), R3.1
unnamed: D2.1 (K), R9.1
unnamed: C18.1, J4.1 (In), R11.1
unnamed: C3.1, R2.2, SW2.2 (B), U1.7 (NRST)
unnamed: R5.2, U3.19 (SCL/SPI_CLK)
unnamed: R6.2, U3.18 (SDA/~SPI_CS)
unnamed: C20.1, R11.2, U6.12 (ANT)
OSC_IN: C1.1, U1.5 (PD0), Y1.1
OSC_OUT: R1.1, U1.6 (PD1)
PYRO_1: J6.5, U1.19 (PB1)
PYRO_2: J6.6, U1.20 (PB2)
SPI1_MISO: U1.16 (PA6), U2.5 (SDO)
SPI1_MOSI: U1.17 (PA7), U2.4 (SDI)
SPI1_SCK: U1.15 (PA5), U2.2 (SCK)
SPI2_MISO: J2.7 (DAT0), U1.27 (PB14)
SPI2_MOSI: J2.3 (CMD), U1.28 (PB15)
SPI2_SCK: J2.5 (CLK), U1.26 (PB13)
SWCLK: J5.3, U1.37 (PA14)
SWDIO: J5.2, U1.34 (PA13)
VCC_RF: R10.1, U3.9 (VCC_RF)

Notes on the sheet:
MicroSD
GPS
SMA CONNECTOR
Barometer
Mounting Holes
HOT START
LORA
ST-LINK

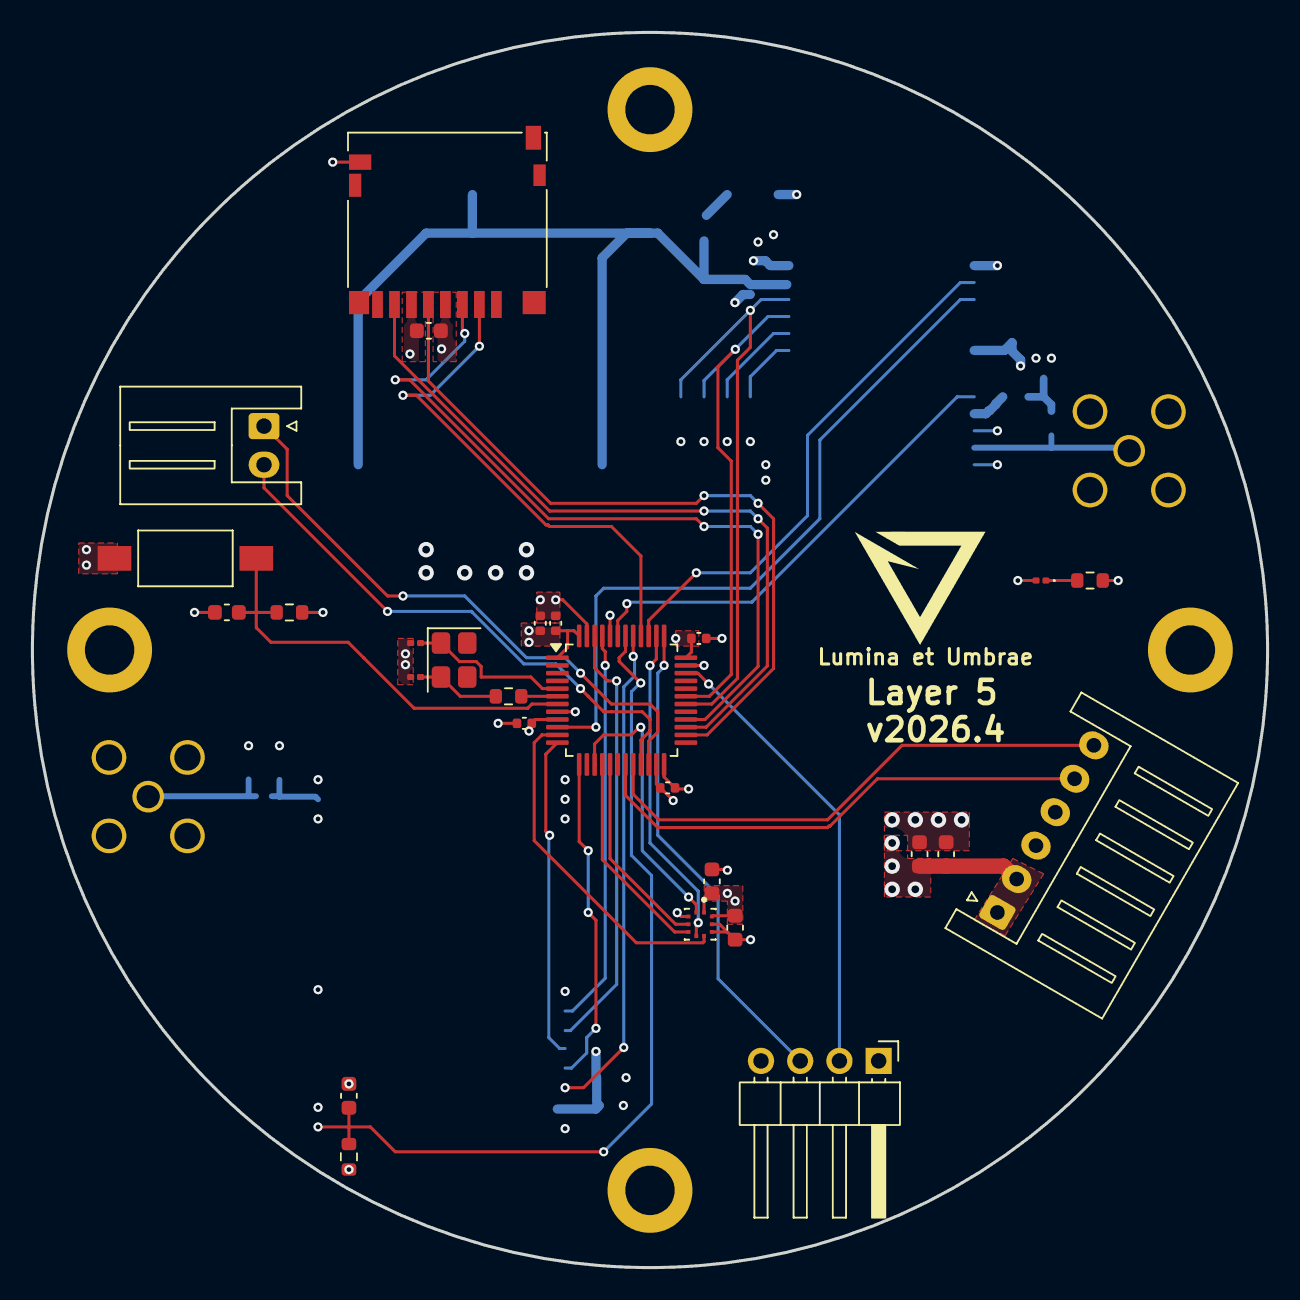
[picture p10: board 台灣盃航電倉次系統.kicad_pcb from above]

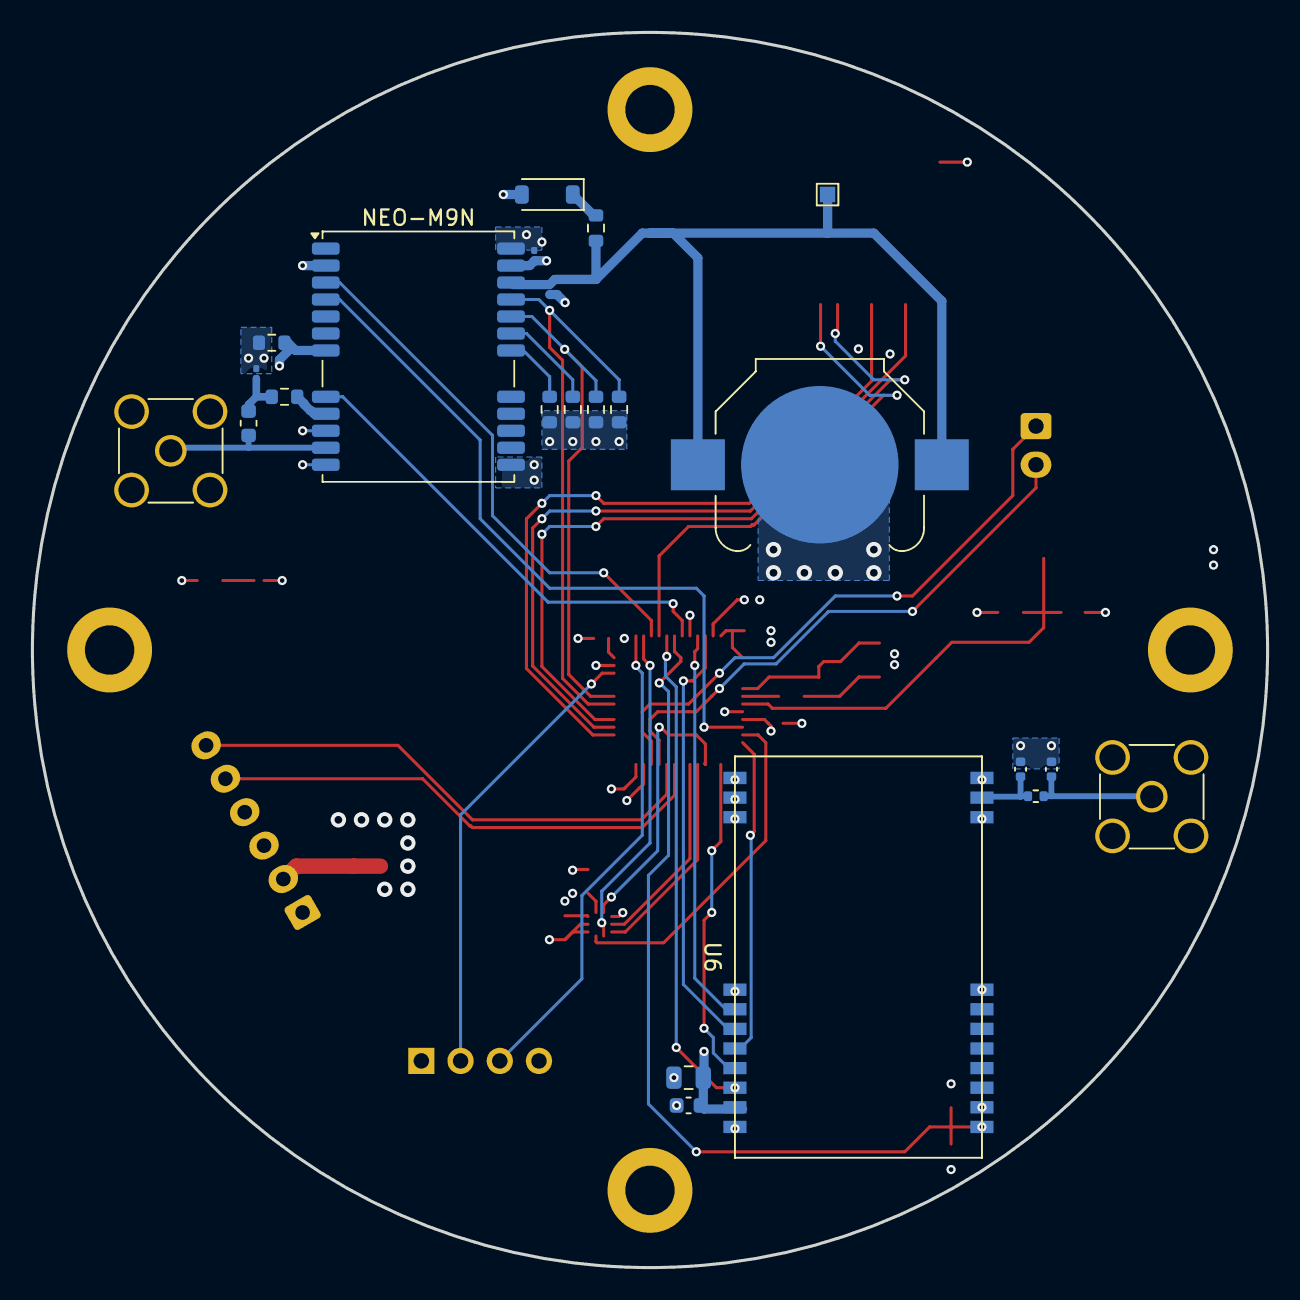
[picture p11: board 台灣盃航電倉次系統.kicad_pcb from below]

Board: 4 copper layers, 80.0 x 80.0 mm, 54 parts (23 on the bottom side), 42 nets.
