rat0mu/2026-Rocket-Taiwan-Cup/avionics/hardware/pcb/台灣盃航電艙第2層_通訊/台灣盃航電倉上層.kicad_pcb

## KiCad design avionics/hardware/pcb/台灣盃航電艙第2層_通訊/台灣盃航電倉上層.kicad_pcb (2026-05-03)

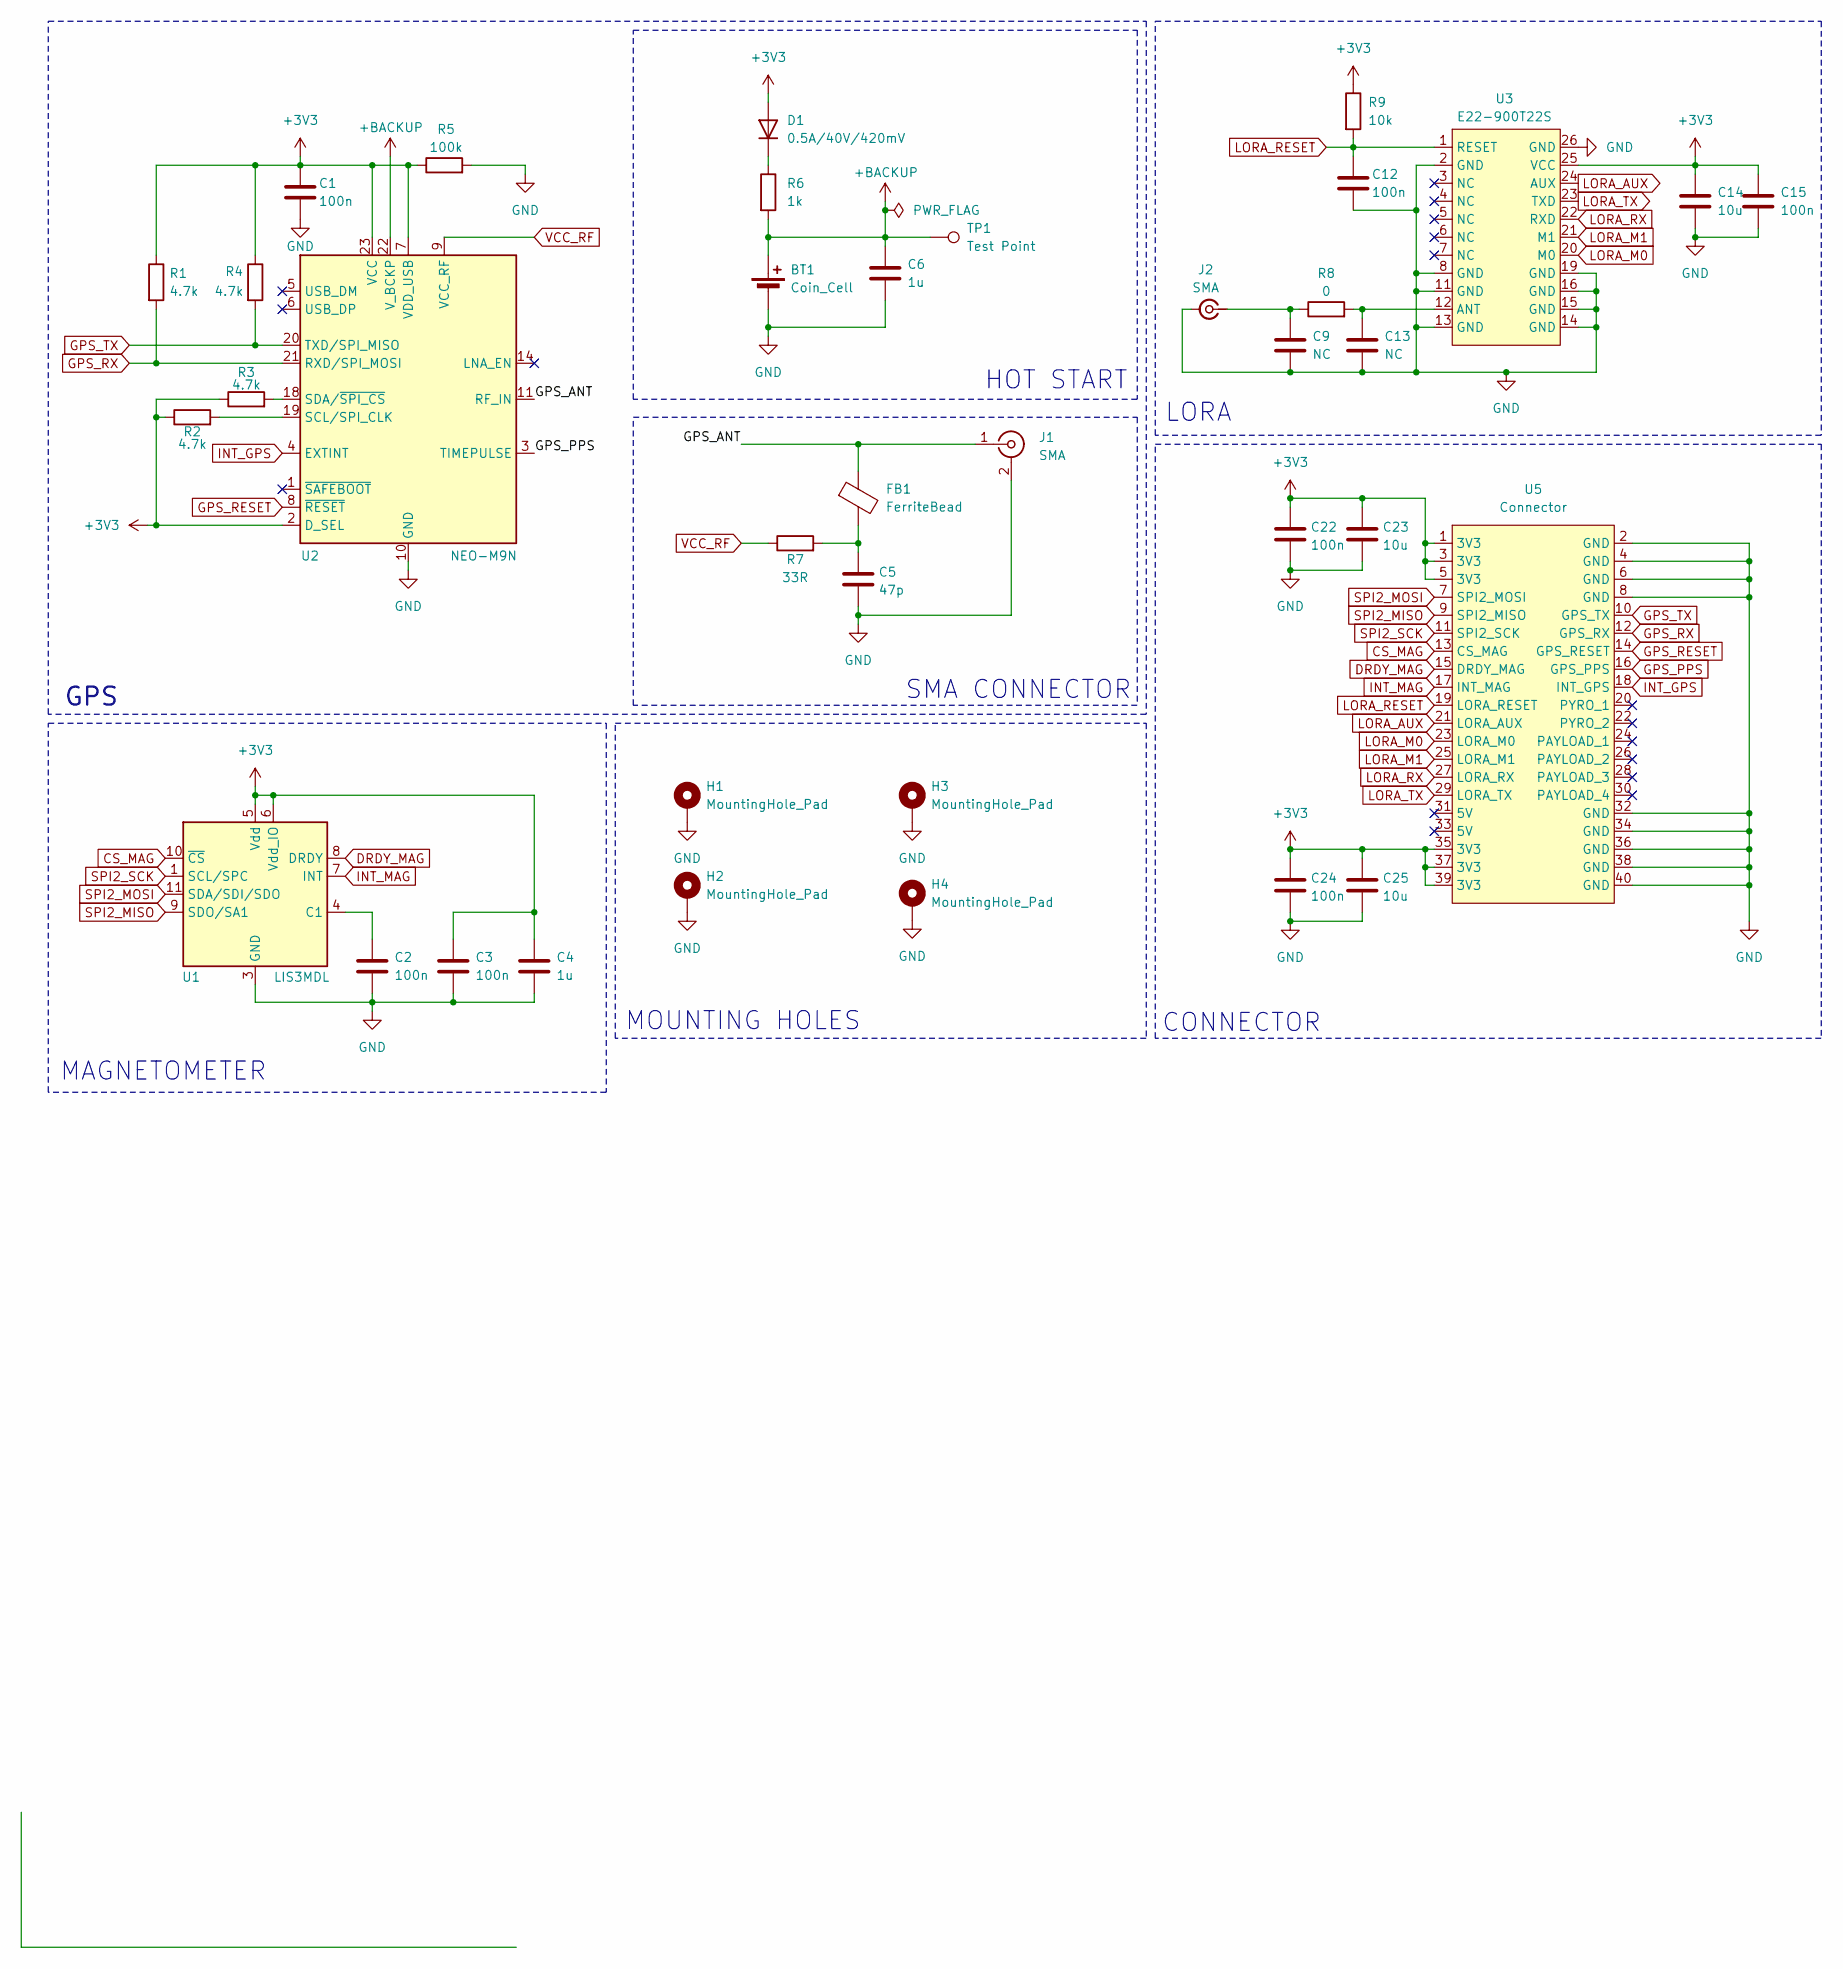
[picture p12: schematic 台灣盃航電倉上層.kicad_sch]

Parts:
BT1: Coin_Cell; BatteryHolder_Keystone_3000_1x12mm
C1: 100n; C_0201_0603Metric
C2, C3, C12, C15: 100n; C_0603_1608Metric
C4: 1u; C_0603_1608Metric
C5: 47p; C_0201_0603Metric
C6: 1u; C_0201_0603Metric
C9, C13: NC; C_0402_1005Metric
C14: 10u; C_0805_2012Metric
C22, C24: 100n; C_0402_1005Metric
C23, C25: 10u; C_0603_1608Metric
D1: 0.5A/40V/420mV; D_SOD-123
FB1: FerriteBead; L_0603_1608Metric
H1, H2, H3, H4: MountingHole_Pad; MountingHole_2.2mm_M2_DIN965_Pad
J1, J2: SMA; SMA_Amphenol_132134-11_Vertical
R1, R2, R3, R4: 4.7k; R_0603_1608Metric
R5: 100k; R_0603_1608Metric
R6: 1k; R_0603_1608Metric
R7: 33R; R_0603_1608Metric
R8: 0; R_0402_1005Metric
R9: 10k; R_0603_1608Metric
TP1: Test Point; TestPoint_Pad_1.0x1.0mm
U1: LIS3MDL; LGA-12_2x2mm_P0.5mm
U2: NEO-M9N; ublox_NEO
U3: E22-900T22S; PE22-230T22S
U5: Connector; PinHeader_2x20_P2.54mm_Vertical

Connections:
+3V3: C1.1, C3.1, C4.1, C14.1, C15.1, C22.1, C23.1, C24.1, C25.1, D1.2 (A), R1.1, R2.1, R3.1, R4.1, R5.1, R9.1, U1.5 (Vdd), U1.6 (Vdd_IO), U2.2 (D_SEL), U2.7 (VDD_USB), U2.23 (VCC), U3.25 (VCC), U5.1 (3V3), U5.3 (3V3), U5.5 (3V3), U5.35 (3V3), U5.37 (3V3), U5.39 (3V3)
+BACKUP: BT1.1 (+), C6.1, R6.2, TP1.1, U2.22 (V_BCKP)
/GPS_ANT: FB1.1, J1.1 (In), U2.11 (RF_IN)
CS_MAG: U1.10 (~CS), U5.13 (CS_MAG)
DRDY_MAG: U1.8 (DRDY), U5.15 (DRDY_MAG)
GND: BT1.2 (-), C1.2, C2.2, C3.2, C4.2, C5.2, C6.2, C9.2, C12.2, C13.2, C14.2, C15.2, C22.2, C23.2, C24.2, C25.2, H1.1, H2.1, H3.1, H4.1, J1.2 (Ext), J2.2 (Ext), R5.2, U1.2 (GND), U1.3 (GND), U1.12 (GND), U2.10 (GND), U2.12 (GND), U2.13 (GND), U2.24 (GND), U3.2 (GND), U3.8 (GND), U3.11 (GND), U3.13 (GND), U3.14 (GND), U3.15 (GND), U3.16 (GND), U3.19 (GND), U3.26 (GND), U5.2 (GND), U5.4 (GND), U5.6 (GND), U5.8 (GND), U5.32 (GND), U5.34 (GND), U5.36 (GND), U5.38 (GND), U5.40 (GND)
GPS_PPS: U2.3 (TIMEPULSE), U5.16 (GPS_PPS)
GPS_RESET: U2.8 (~RESET), U5.14 (GPS_RESET)
GPS_RX: R1.2, U2.21 (RXD/SPI_MOSI), U5.12 (GPS_RX)
GPS_TX: R4.2, U2.20 (TXD/SPI_MISO), U5.10 (GPS_TX)
INT_GPS: U2.4 (EXTINT), U5.18 (INT_GPS)
INT_MAG: U1.7 (INT), U5.17 (INT_MAG)
LORA_AUX: U3.24 (AUX), U5.21 (LORA_AUX)
LORA_M0: U3.20 (M0), U5.23 (LORA_M0)
LORA_M1: U3.21 (M1), U5.25 (LORA_M1)
LORA_RESET: C12.1, R9.2, U3.1 (RESET), U5.19 (LORA_RESET)
LORA_RX: U3.22 (RXD), U5.27 (LORA_RX)
LORA_TX: U3.23 (TXD), U5.29 (LORA_TX)
unnamed: C5.1, FB1.2, R7.2
unnamed: D1.1 (K), R6.1
unnamed: C9.1, J2.1 (In), R8.1
unnamed: C2.1, U1.4 (C1)
unnamed: R2.2, U2.19 (SCL/SPI_CLK)
unnamed: R3.2, U2.18 (SDA/~SPI_CS)
unnamed: C13.1, R8.2, U3.12 (ANT)
SPI2_MISO: U1.9 (SDO/SA1), U5.9 (SPI2_MISO)
SPI2_MOSI: U1.11 (SDA/SDI/SDO), U5.7 (SPI2_MOSI)
SPI2_SCK: U1.1 (SCL/SPC), U5.11 (SPI2_SCK)
VCC_RF: R7.1, U2.9 (VCC_RF)

Notes on the sheet:
HOT START
MAGNETOMETER
GPS
MOUNTING HOLES
LORA
SMA CONNECTOR
CONNECTOR

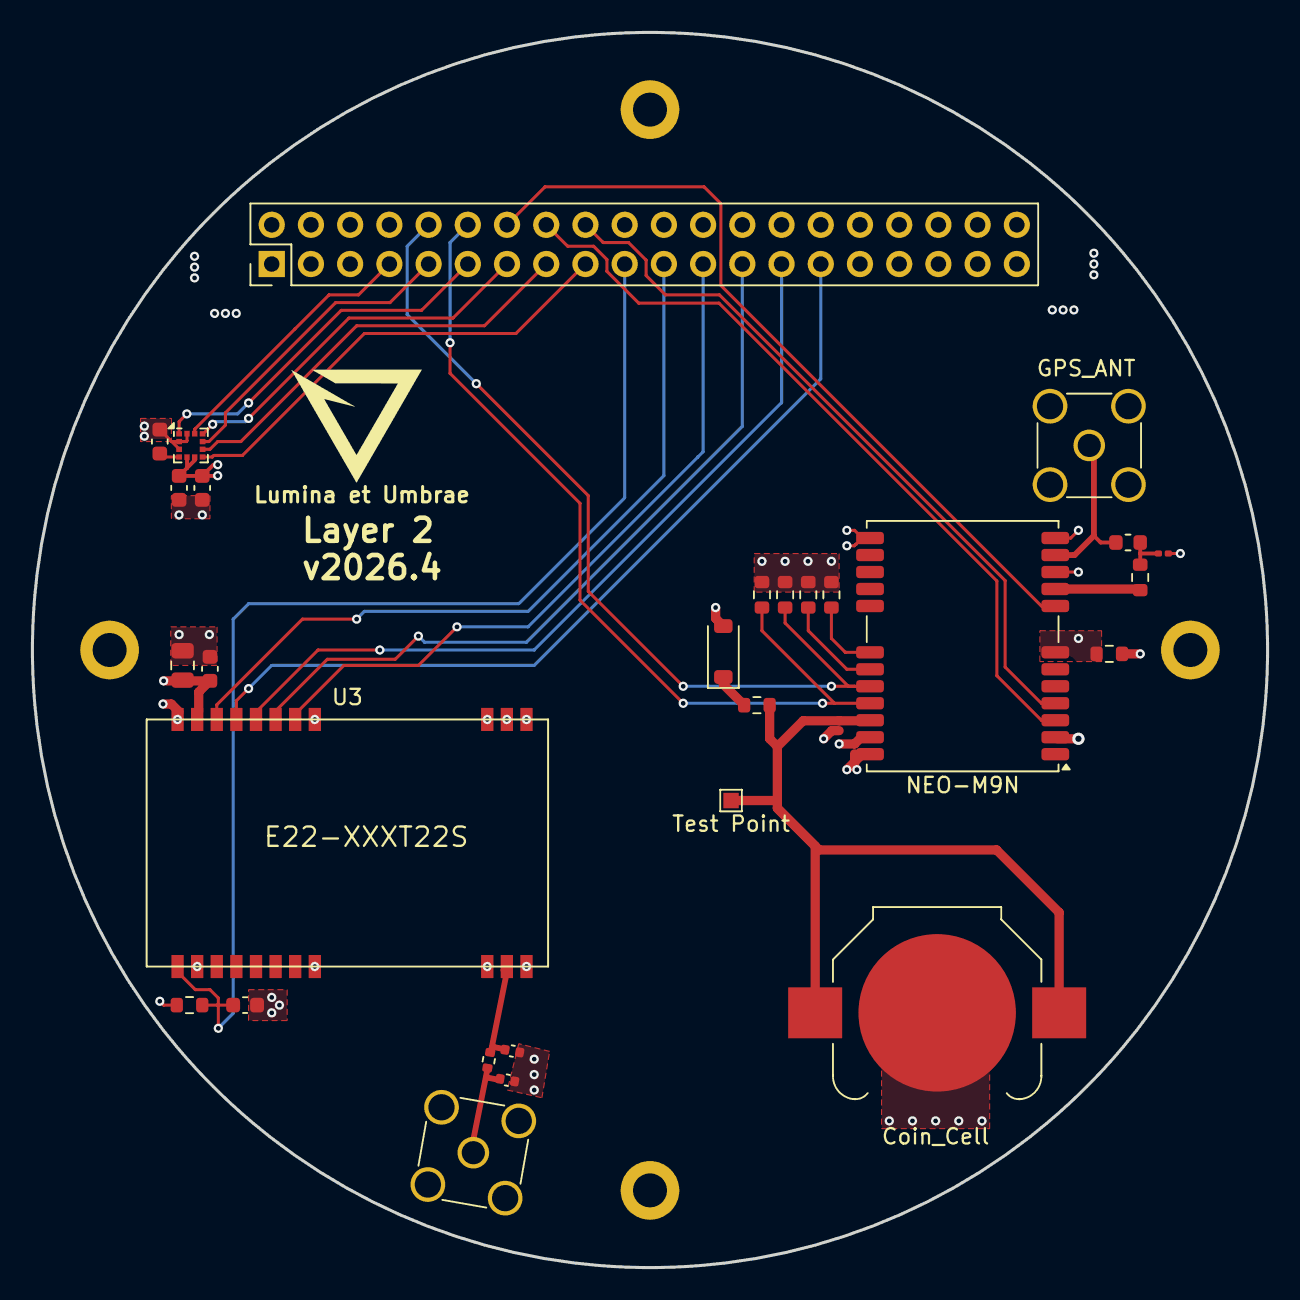
[picture p13: board 台灣盃航電倉上層.kicad_pcb from above]

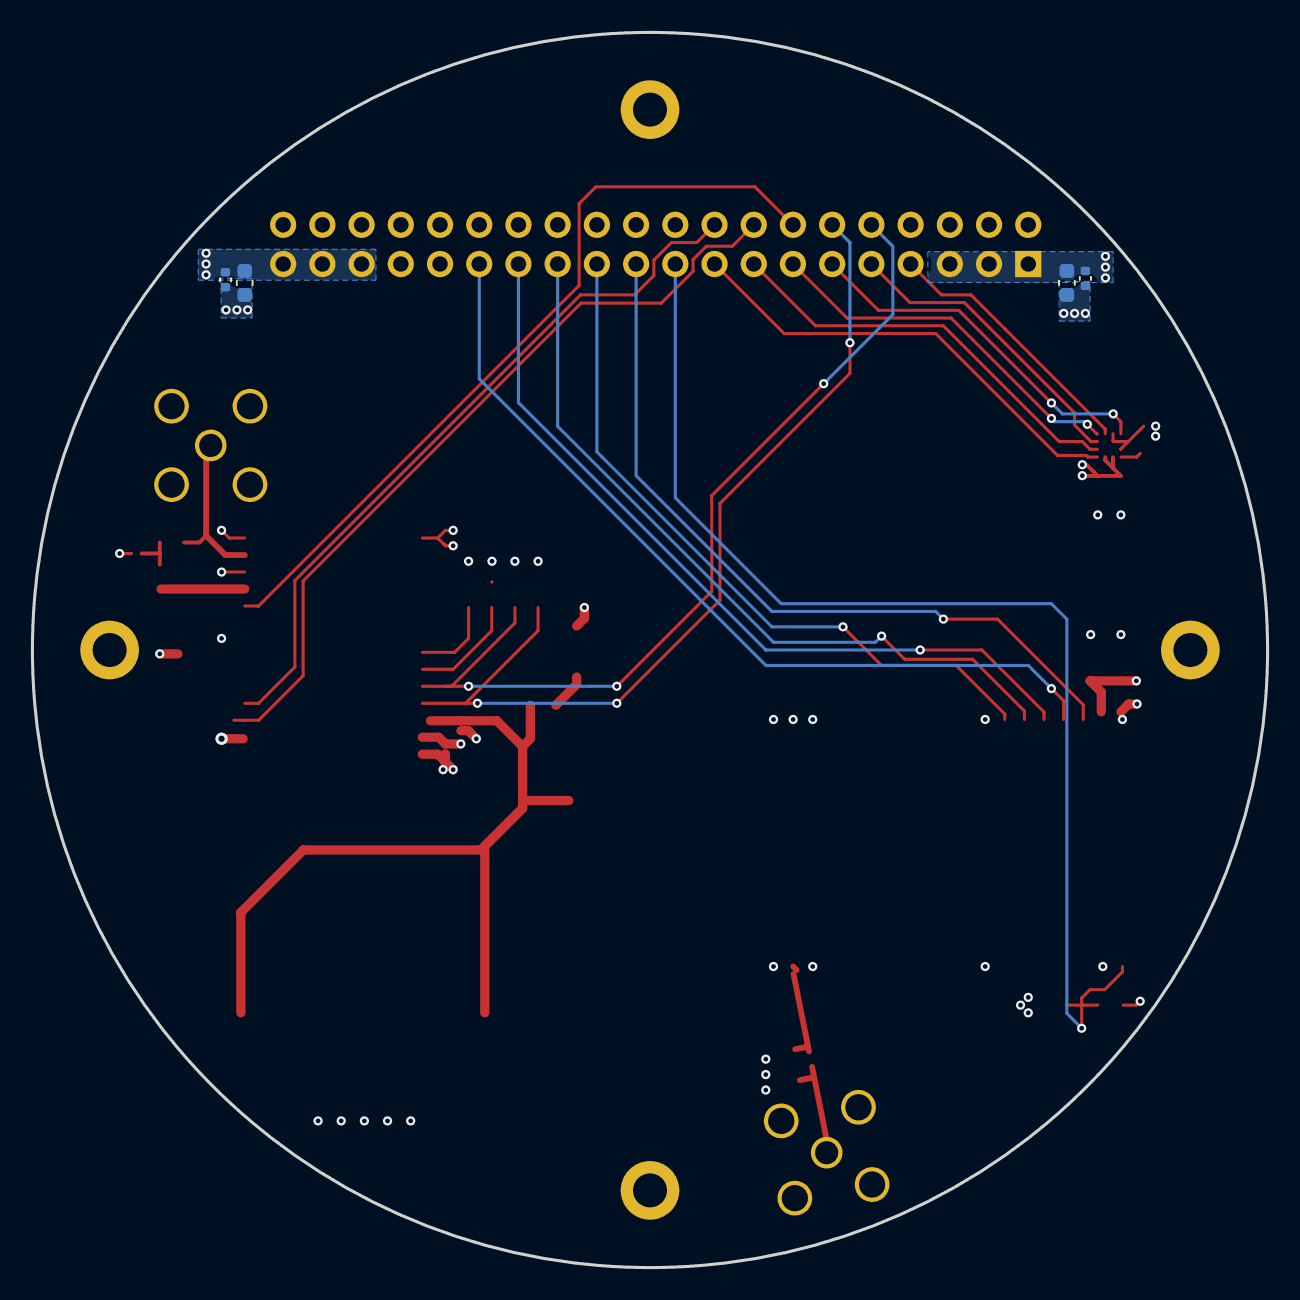
[picture p14: board 台灣盃航電倉上層.kicad_pcb from below]

Board: 4 copper layers, 80.0 x 80.0 mm, 38 parts (4 on the bottom side), 29 nets.
