rat0mu/2026-Rocket-Taiwan-Cup/avionics/hardware/pcb/台灣盃航電艙第4層_供電/台灣盃航電倉下層.kicad_pcb

## KiCad design avionics/hardware/pcb/台灣盃航電艙第4層_供電/台灣盃航電倉下層.kicad_pcb (2026-05-03)

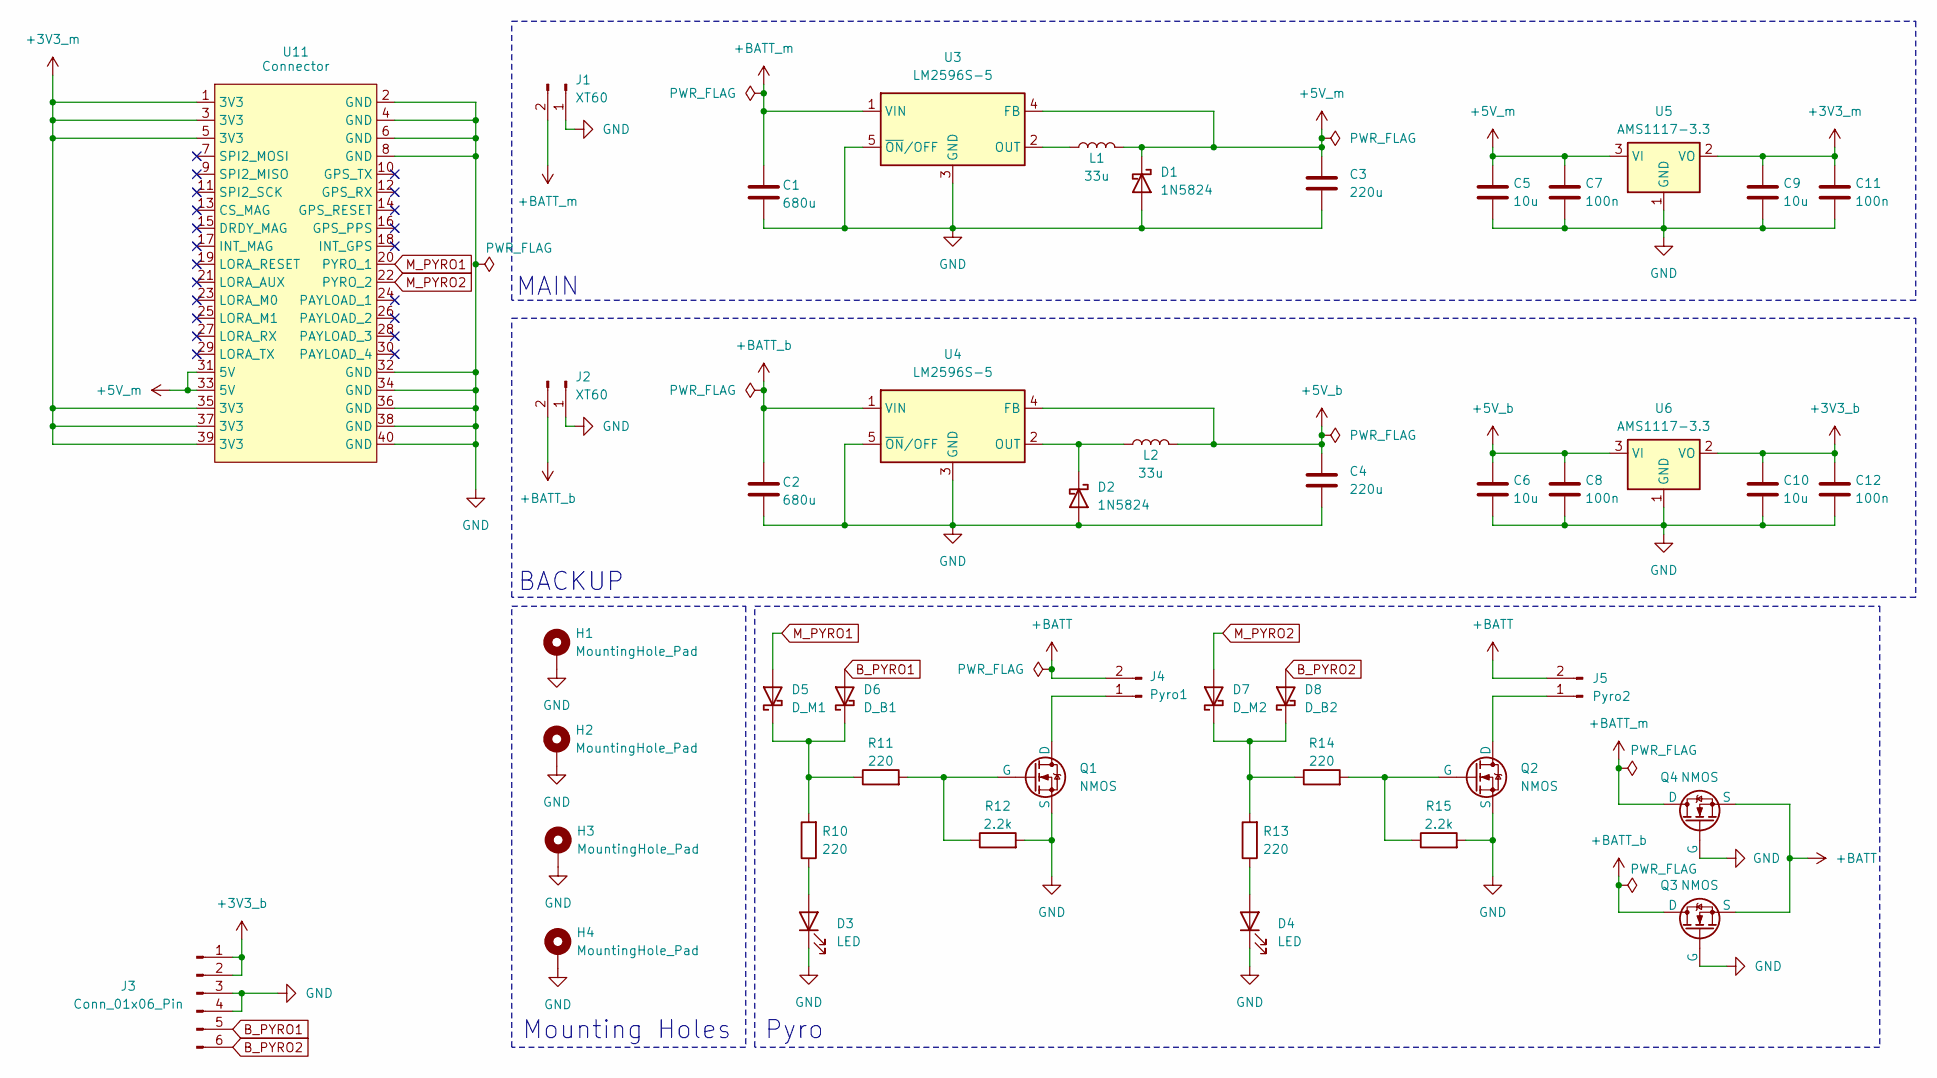
[picture p15: schematic 台灣盃航電倉下層.kicad_sch]

Parts:
C1, C2: 680u; CP_Elec_10x10
C3, C4: 220u; CP_Elec_8x10
C5, C6, C9, C10: 10u; C_0805_2012Metric
C7, C8, C11, C12: 100n; C_0603_1608Metric
D1, D2: 1N5824; D_SMC
D3, D4: LED; LED_0805_2012Metric
D5: D_M1; D_SOD-123
D6: D_B1; D_SOD-123
D7: D_M2; D_SOD-123
D8: D_B2; D_SOD-123
H1, H2, H3, H4: MountingHole_Pad; MountingHole_3.2mm_M3_ISO14580_Pad
J1, J2: XT60; AMASS_XT60PW-M_1x02_P7.20mm_Horizontal
J3: Conn_01x06_Pin; JST_XH_S6B-XH-A_1x06_P2.50mm_Horizontal
J4: Pyro1; JST_XH_S2B-XH-A_1x02_P2.50mm_Horizontal
J5: Pyro2; JST_XH_S2B-XH-A_1x02_P2.50mm_Horizontal
L1, L2: 33u; L_APV_ANR6045
Q1, Q2, Q3, Q4: NMOS; SOT-223
R10, R11, R13, R14: 220; R_0805_2012Metric
R12, R15: 2.2k; R_0805_2012Metric
U3, U4: LM2596S-5; TO-263-5_TabPin3
U5, U6: AMS1117-3.3; SOT-223-3_TabPin2
U11: Connector; PinHeader_2x20_P2.54mm_Vertical

Connections:
+3V3_b: C10.1, C12.1, J3.1, J3.2, U6.2 (VO)
+3V3_m: C9.1, C11.1, U5.2 (VO), U11.1 (3V3), U11.3 (3V3), U11.5 (3V3), U11.35 (3V3), U11.37 (3V3), U11.39 (3V3)
+5V_b: C4.1, C6.1, C8.1, L2.2, U4.4 (FB), U6.3 (VI)
+5V_m: C3.1, C5.1, C7.1, D1.1 (K), L1.2, U3.4 (FB), U5.3 (VI), U11.31 (5V), U11.33 (5V)
+BATT: J4.2, J5.2, Q3.3 (S), Q4.3 (S); also elsewhere on the board
+BATT_b: C2.1, J2.2, Q3.1 (D), U4.1 (VIN)
+BATT_m: C1.1, J1.2, Q4.1 (D), U3.1 (VIN)
B_PYRO1: D6.2 (A), J3.5
B_PYRO2: D8.2 (A), J3.6
GND: C1.2, C2.2, C3.2, C4.2, C5.2, C6.2, C7.2, C8.2, C9.2, C10.2, C11.2, C12.2, D1.2 (A), D2.2 (A), D3.1 (K), D4.1 (K), H1.1, H2.1, H3.1, H4.1, J1.1, J2.1, J3.3, J3.4, Q1.3 (S), Q2.3 (S), Q3.2 (G), Q4.2 (G), R12.2, R15.2, U3.3 (GND), U3.5 (~ON/OFF), U4.3 (GND), U4.5 (~ON/OFF), U5.1 (GND), U6.1 (GND), U11.2 (GND), U11.4 (GND), U11.6 (GND), U11.8 (GND), U11.32 (GND), U11.34 (GND), U11.36 (GND), U11.38 (GND), U11.40 (GND)
M_PYRO1: D5.2 (A), U11.20 (PYRO_1)
M_PYRO2: D7.2 (A), U11.22 (PYRO_2)
unnamed: D2.1 (K), L2.1, U4.2 (OUT)
unnamed: D3.2 (A), R10.1
unnamed: D4.2 (A), R13.1
unnamed: D5.1 (K), D6.1 (K), R10.2, R11.1
unnamed: D7.1 (K), D8.1 (K), R13.2, R14.1
unnamed 17: J4.1, Q1.1 (D); also elsewhere on the board
unnamed 18: J5.1, Q2.1 (D); also elsewhere on the board
unnamed: Q1.2 (G), R11.2, R12.1
unnamed: Q2.2 (G), R14.2, R15.1
unnamed: L1.1, U3.2 (OUT)

Notes on the sheet:
MAIN
Pyro
BACKUP
Mounting Holes
