rat0mu/2026-Rocket-Taiwan-Cup/avionics/hardware/pcb/台灣盃航電艙第4層_供電/台灣盃航電倉下層.kicad_pcb

## KiCad design avionics/hardware/pcb/台灣盃航電艙第4層_供電/台灣盃航電倉下層.kicad_pcb (continued)

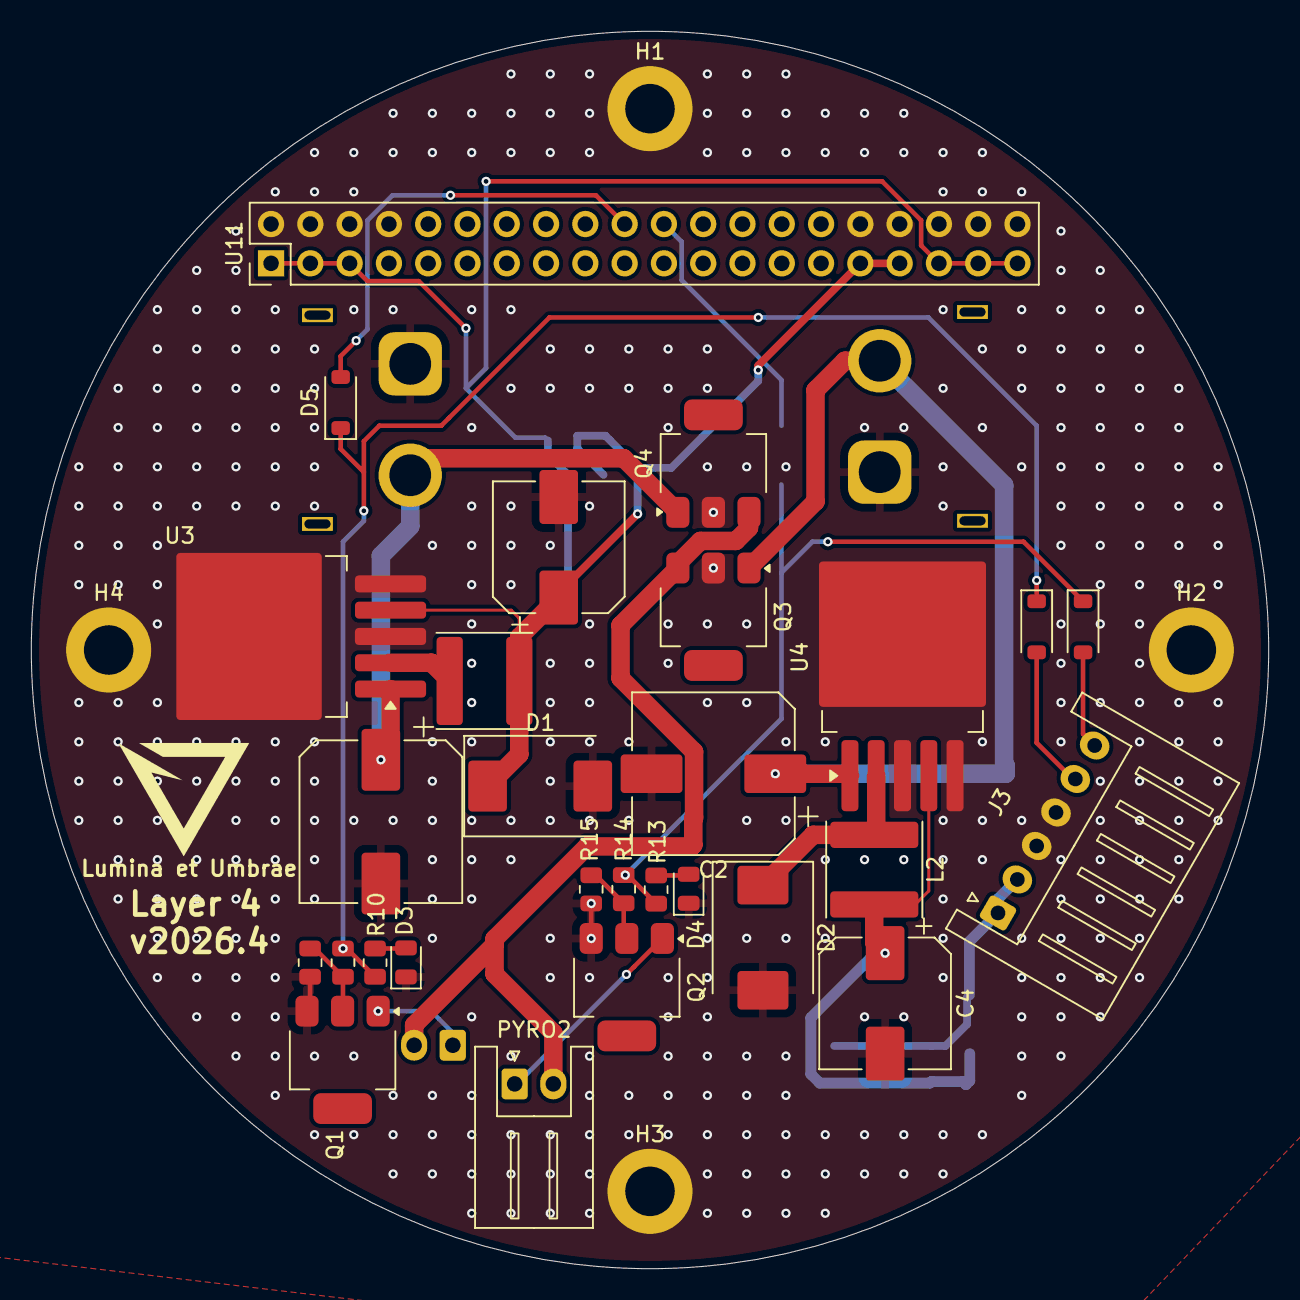
[picture p16: board 台灣盃航電倉下層.kicad_pcb from above]

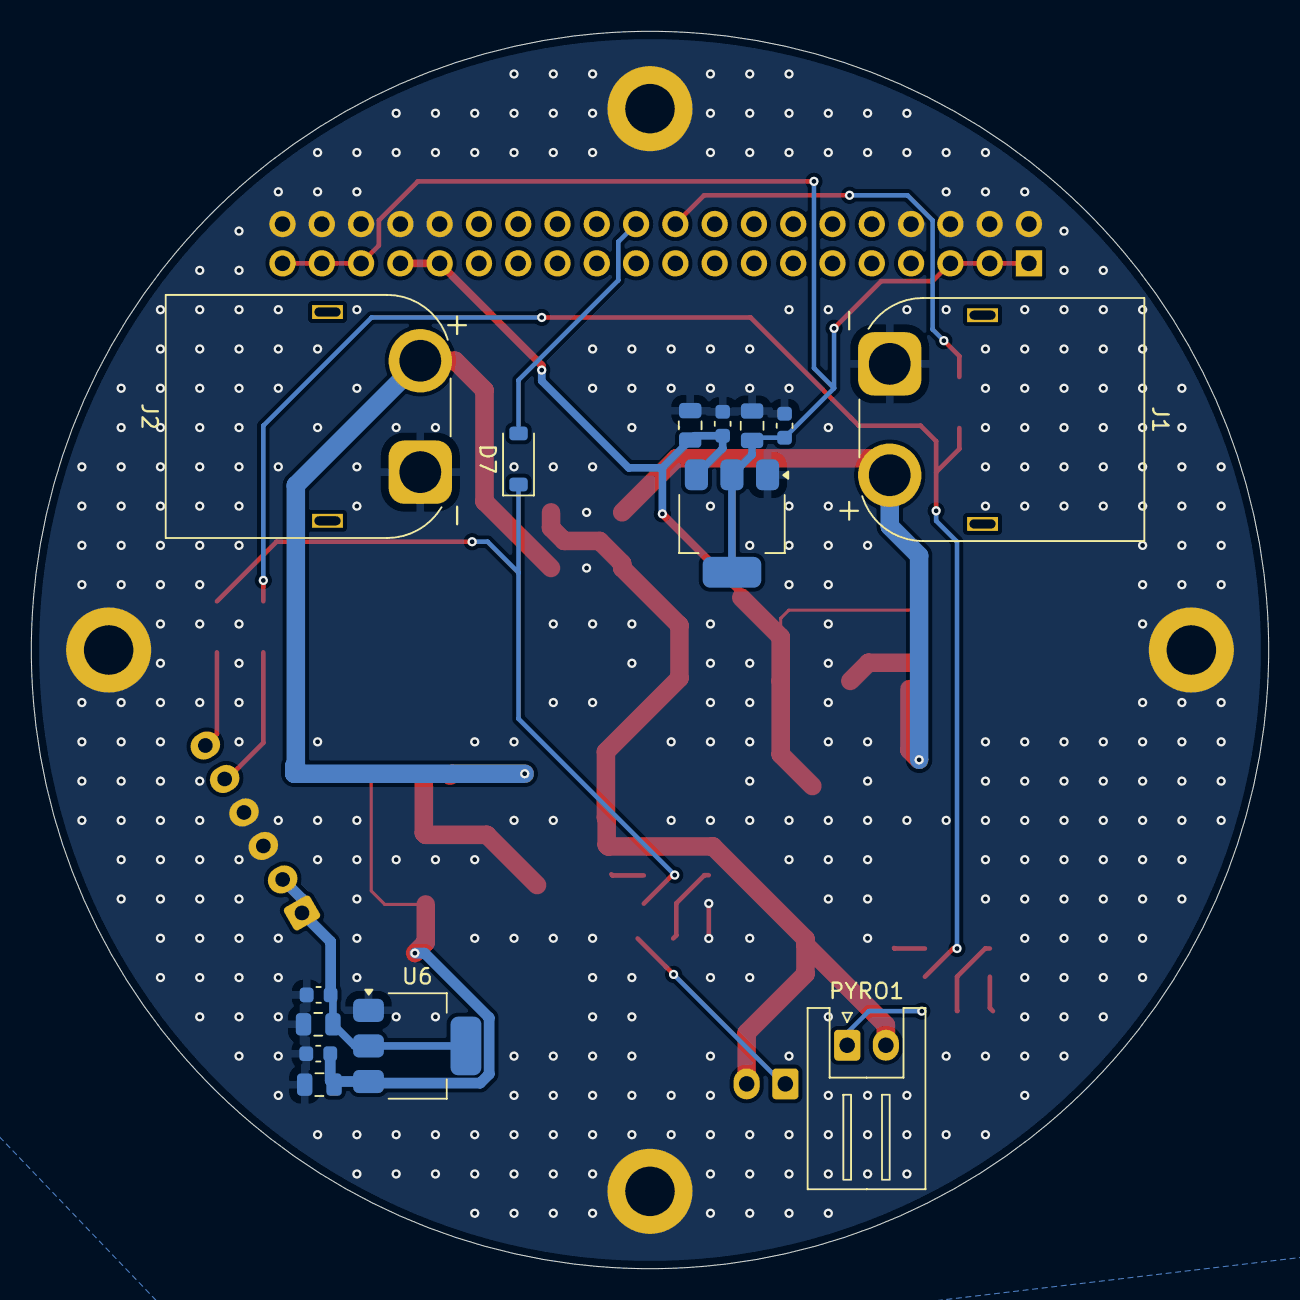
[picture p17: board 台灣盃航電倉下層.kicad_pcb from below]

Board: 2 copper layers, 80.0 x 80.0 mm, 46 parts (14 on the bottom side), 22 nets.

Other parts of the board:
PYRO1: Pyro1; JST_XH_S2B-XH-A_1x02_P2.50mm_Horizontal
PYRO2: Pyro2; JST_XH_S2B-XH-A_1x02_P2.50mm_Horizontal

Their connections:
+BATT: PYRO1.2, PYRO2.2; also elsewhere on the board
unnamed 17: PYRO1.1; also elsewhere on the board
unnamed 18: PYRO2.1; also elsewhere on the board
