rat0mu/2026-Rocket-Taiwan-Cup/avionics/hardware/pcb/台灣盃航電艙第3層_主系統/台灣盃航電艙中層.kicad_pcb

## KiCad design avionics/hardware/pcb/台灣盃航電艙第3層_主系統/台灣盃航電艙中層.kicad_pcb (2026-05-03)

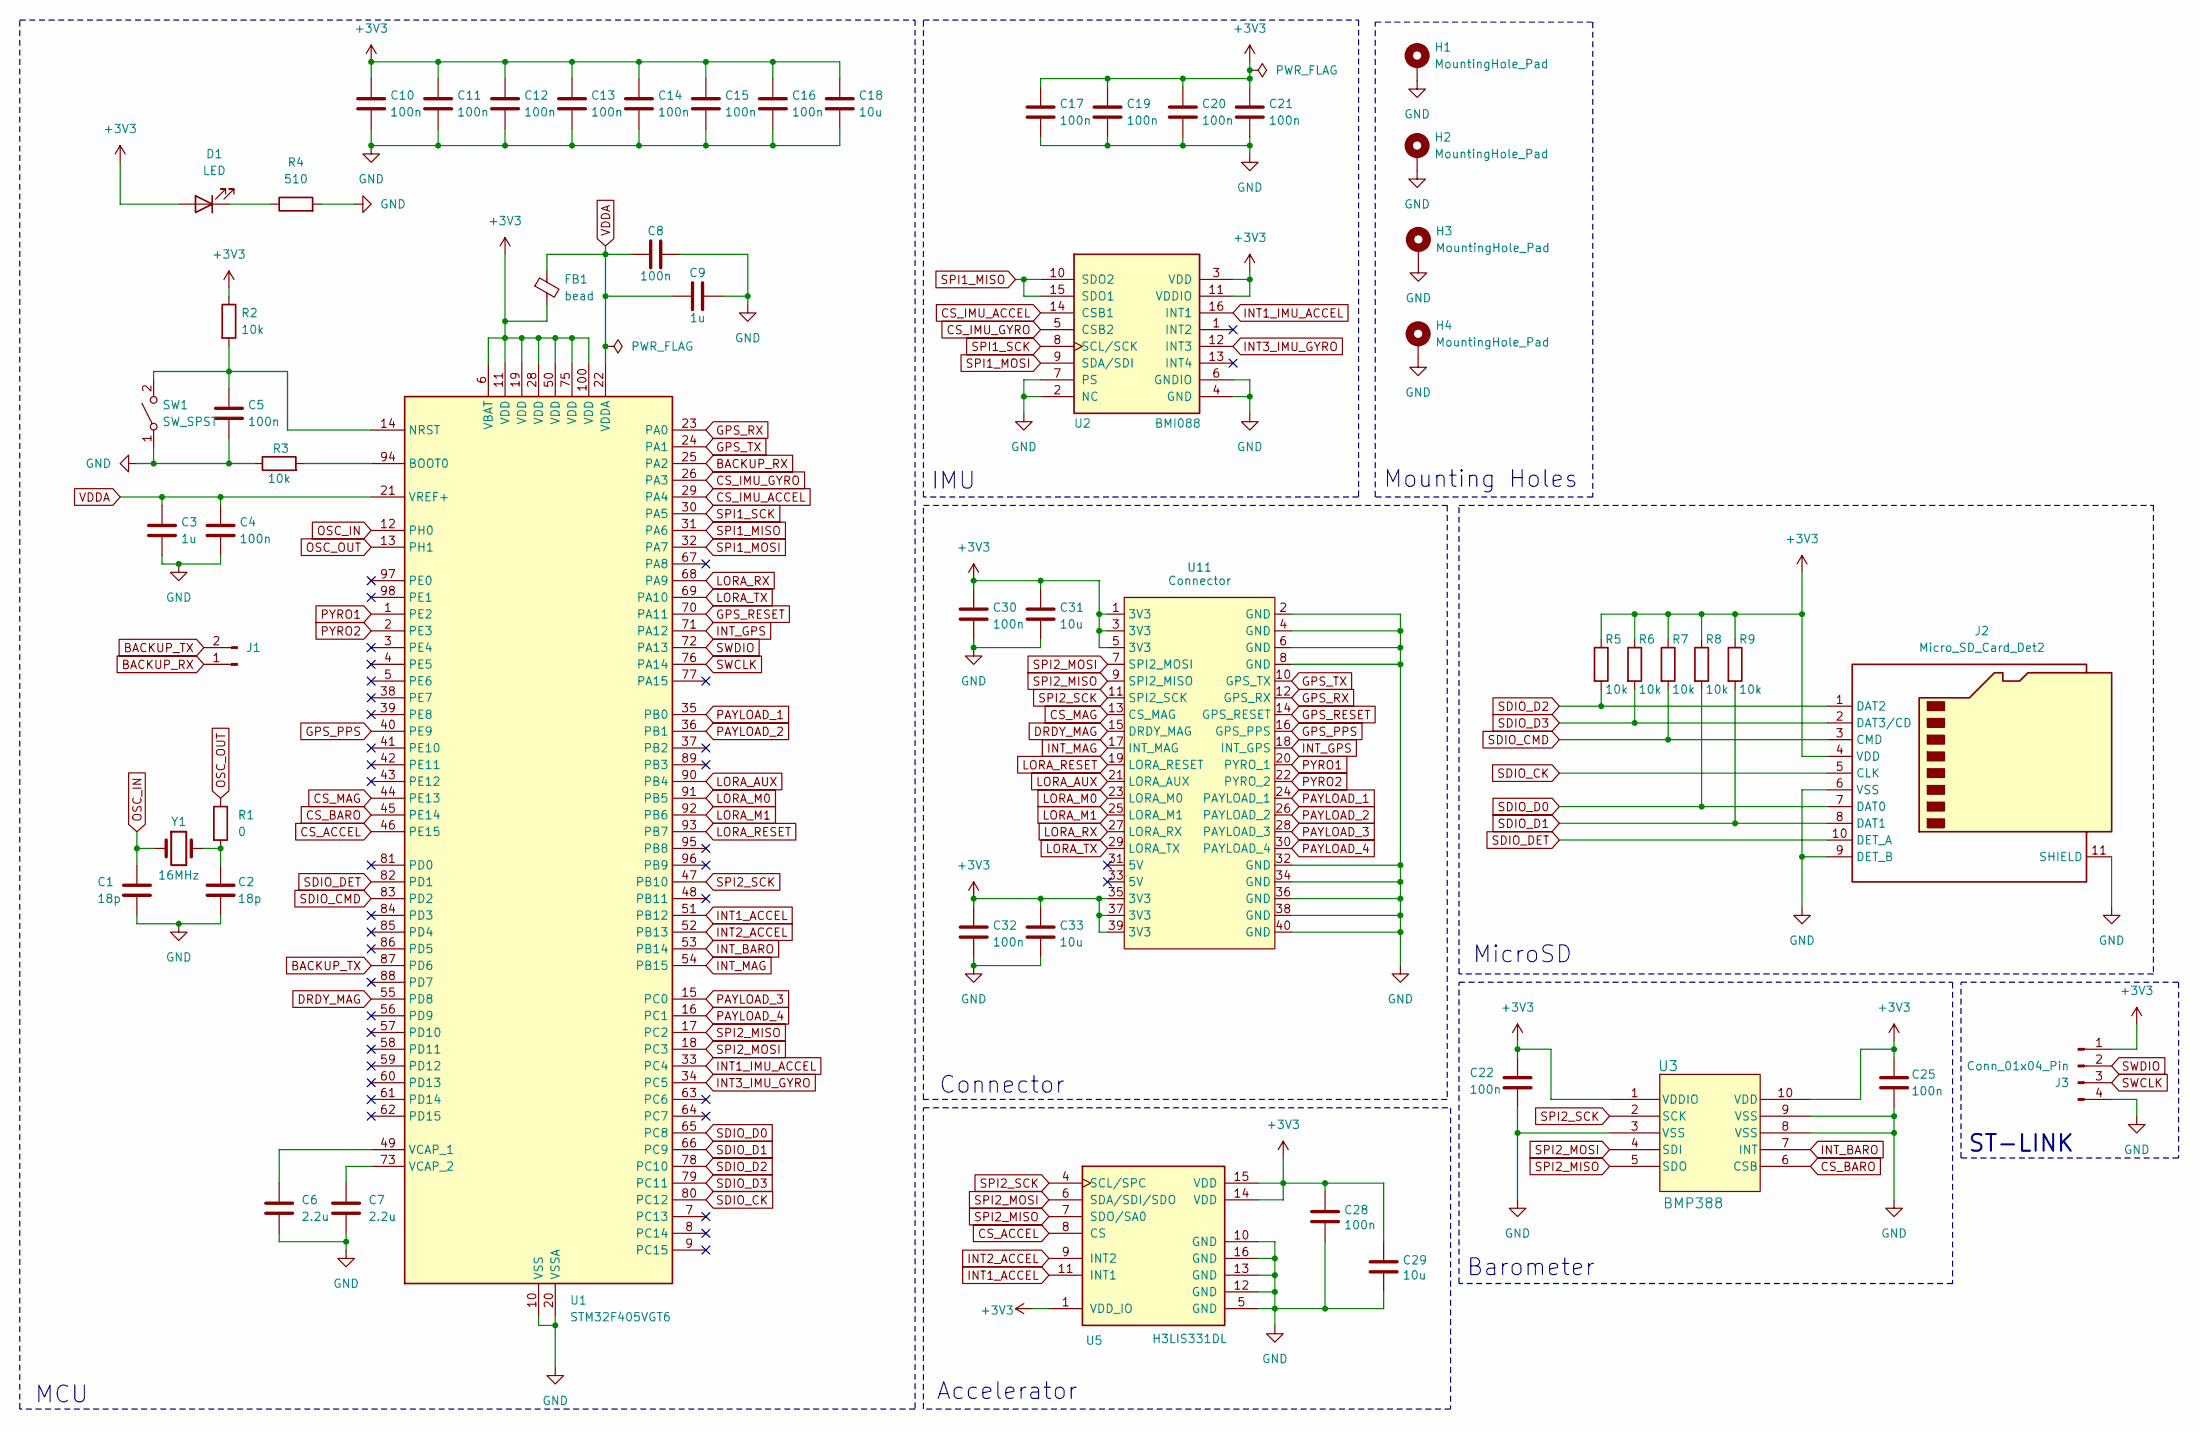
[picture p18: schematic 台灣盃航電艙中層.kicad_sch]

Parts:
C1, C2: 18p; C_0603_1608Metric
C3, C9: 1u; C_0603_1608Metric
C4, C5, C8, C10, C11, C12, C13, C14, C15, C16, C17, C19, C20, C21, C22, C25, C28: 100n; C_0603_1608Metric
C6, C7: 2.2u; C_0805_2012Metric
C18, C29: 10u; C_0805_2012Metric
C30, C32: 100n; C_0402_1005Metric
C31, C33: 10u; C_0603_1608Metric
D1: LED; LED_0805_2012Metric
FB1: bead; L_0603_1608Metric
H1, H2, H3, H4: MountingHole_Pad; MountingHole_3.2mm_M3_ISO14580_Pad
J1: JST_XH_S2B-XH-A_1x02_P2.50mm_Horizontal
J2: Micro_SD_Card_Det2; microSD_HC_Hirose_DM3D-SF
J3: Conn_01x04_Pin; PinHeader_1x04_P2.54mm_Horizontal
R1: 0; R_0603_1608Metric
R2, R5, R6, R7, R8, R9: 10k; R_0603_1608Metric
R3: 10k; C_0603_1608Metric
R4: 510; R_0805_2012Metric
SW1: SW_SPST; SW_SPST_FSMSM
U1: STM32F405VGT6; LQFP-100_14x14mm_P0.5mm
U2: BMI088; PQFN50P450X300X100-16N
U3: BMP388; XDCR_BMP390L
U5: H3LIS331DL; QFN300X300X100-16N
U11: Connector; PinHeader_2x20_P2.54mm_Vertical
Y1: 16MHz; Crystal_SMD_3225-4Pin_3.2x2.5mm

Connections:
+3V3: C10.1, C11.1, C12.1, C13.1, C14.1, C15.1, C16.1, C17.1, C18.1, C19.1, C20.1, C21.1, C22.1, C25.1, C28.1, C29.1, C30.1, C31.1, C32.1, C33.1, D1.2 (A), FB1.2, J2.4 (VDD), J3.1, R2.1, R5.1, R6.1, R7.1, R8.1, R9.1, U1.6 (VBAT), U1.11 (VDD), U1.19 (VDD), U1.28 (VDD), U1.50 (VDD), U1.75 (VDD), U1.100 (VDD), U2.3 (VDD), U2.11 (VDDIO), U3.1 (VDDIO), U3.10 (VDD), U5.1 (VDD_IO), U5.14 (VDD), U5.15 (VDD), U11.1 (3V3), U11.3 (3V3), U11.5 (3V3), U11.35 (3V3), U11.37 (3V3), U11.39 (3V3)
BACKUP_RX: J1.1, U1.25 (PA2)
BACKUP_TX: J1.2, U1.87 (PD6)
CS_ACCEL: U1.46 (PE15), U5.8 (CS)
CS_BARO: U1.45 (PE14), U3.6 (CSB)
CS_IMU_ACCEL: U1.29 (PA4), U2.14 (CSB1)
CS_IMU_GYRO: U1.26 (PA3), U2.5 (CSB2)
CS_MAG: U1.44 (PE13), U11.13 (CS_MAG)
DRDY_MAG: U1.55 (PD8), U11.15 (DRDY_MAG)
GND: C1.2, C2.2, C3.2, C4.2, C5.2, C6.2, C7.2, C8.1, C9.2, C10.2, C11.2, C12.2, C13.2, C14.2, C15.2, C16.2, C17.2, C18.2, C19.2, C20.2, C21.2, C22.2, C25.2, C28.2, C29.2, C30.2, C31.2, C32.2, C33.2, H1.1, H2.1, H3.1, H4.1, J2.6 (VSS), J2.9 (DET_B), J2.11 (SHIELD), J3.4, R3.1, R4.2, SW1.1 (A), U1.10 (VSS), U1.20 (VSSA), U1.27 (VSS), U1.74 (VSS), U1.99 (VSS), U2.2 (NC), U2.4 (GND), U2.6 (GNDIO), U2.7 (PS), U3.3 (VSS), U3.8 (VSS), U3.9 (VSS), U5.5 (GND), U5.10 (GND), U5.12 (GND), U5.13 (GND), U5.16 (GND), U11.2 (GND), U11.4 (GND), U11.6 (GND), U11.8 (GND), U11.32 (GND), U11.34 (GND), U11.36 (GND), U11.38 (GND), U11.40 (GND)
GPS_PPS: U1.40 (PE9), U11.16 (GPS_PPS)
GPS_RESET: U1.70 (PA11), U11.14 (GPS_RESET)
GPS_RX: U1.23 (PA0), U11.12 (GPS_RX)
GPS_TX: U1.24 (PA1), U11.10 (GPS_TX)
INT1_ACCEL: U1.51 (PB12), U5.11 (INT1)
INT1_IMU_ACCEL: U1.33 (PC4), U2.16 (INT1)
INT2_ACCEL: U1.52 (PB13), U5.9 (INT2)
INT3_IMU_GYRO: U1.34 (PC5), U2.12 (INT3)
INT_BARO: U1.53 (PB14), U3.7 (INT)
INT_GPS: U1.71 (PA12), U11.18 (INT_GPS)
INT_MAG: U1.54 (PB15), U11.17 (INT_MAG)
LORA_AUX: U1.90 (PB4), U11.21 (LORA_AUX)
LORA_M0: U1.91 (PB5), U11.23 (LORA_M0)
LORA_M1: U1.92 (PB6), U11.25 (LORA_M1)
LORA_RESET: U1.93 (PB7), U11.19 (LORA_RESET)
LORA_RX: U1.68 (PA9), U11.27 (LORA_RX)
LORA_TX: U1.69 (PA10), U11.29 (LORA_TX)
unnamed: C2.1, R1.2, Y1.2
unnamed: D1.1 (K), R4.1
unnamed: C5.1, R2.2, SW1.2 (B), U1.14 (NRST)
unnamed: R3.2, U1.94 (BOOT0)
unnamed: C6.1, U1.49 (VCAP_1)
unnamed: C7.1, U1.73 (VCAP_2)
OSC_IN: C1.1, U1.12 (PH0), Y1.1
OSC_OUT: R1.1, U1.13 (PH1)
PAYLOAD_1: U1.35 (PB0), U11.24 (PAYLOAD_1)
PAYLOAD_2: U1.36 (PB1), U11.26 (PAYLOAD_2)
PAYLOAD_3: U1.15 (PC0), U11.28 (PAYLOAD_3)
PAYLOAD_4: U1.16 (PC1), U11.30 (PAYLOAD_4)
PYRO1: U1.1 (PE2), U11.20 (PYRO_1)
PYRO2: U1.2 (PE3), U11.22 (PYRO_2)
SDIO_CK: J2.5 (CLK), U1.80 (PC12)
SDIO_CMD: J2.3 (CMD), R7.2, U1.83 (PD2)
SDIO_D0: J2.7 (DAT0), R8.2, U1.65 (PC8)
SDIO_D1: J2.8 (DAT1), R9.2, U1.66 (PC9)
SDIO_D2: J2.1 (DAT2), R5.2, U1.78 (PC10)
SDIO_D3: J2.2 (DAT3/CD), R6.2, U1.79 (PC11)
SDIO_DET: J2.10 (DET_A), U1.82 (PD1)
SPI1_MISO: U1.31 (PA6), U2.10 (SDO2), U2.15 (SDO1)
SPI1_MOSI: U1.32 (PA7), U2.9 (SDA/SDI)
SPI1_SCK: U1.30 (PA5), U2.8 (SCL/SCK)
SPI2_MISO: U1.17 (PC2), U3.5 (SDO), U5.7 (SDO/SA0), U11.9 (SPI2_MISO)
SPI2_MOSI: U1.18 (PC3), U3.4 (SDI), U5.6 (SDA/SDI/SDO), U11.7 (SPI2_MOSI)
SPI2_SCK: U1.47 (PB10), U3.2 (SCK), U5.4 (SCL/SPC), U11.11 (SPI2_SCK)
SWCLK: J3.3, U1.76 (PA14)
SWDIO: J3.2, U1.72 (PA13)
VDDA: C3.1, C4.1, C8.2, C9.1, FB1.1, U1.21 (VREF+), U1.22 (VDDA)

Notes on the sheet:
IMU
MCU
Mounting Holes
Accelerator
MicroSD
Connector
ST-LINK
Barometer

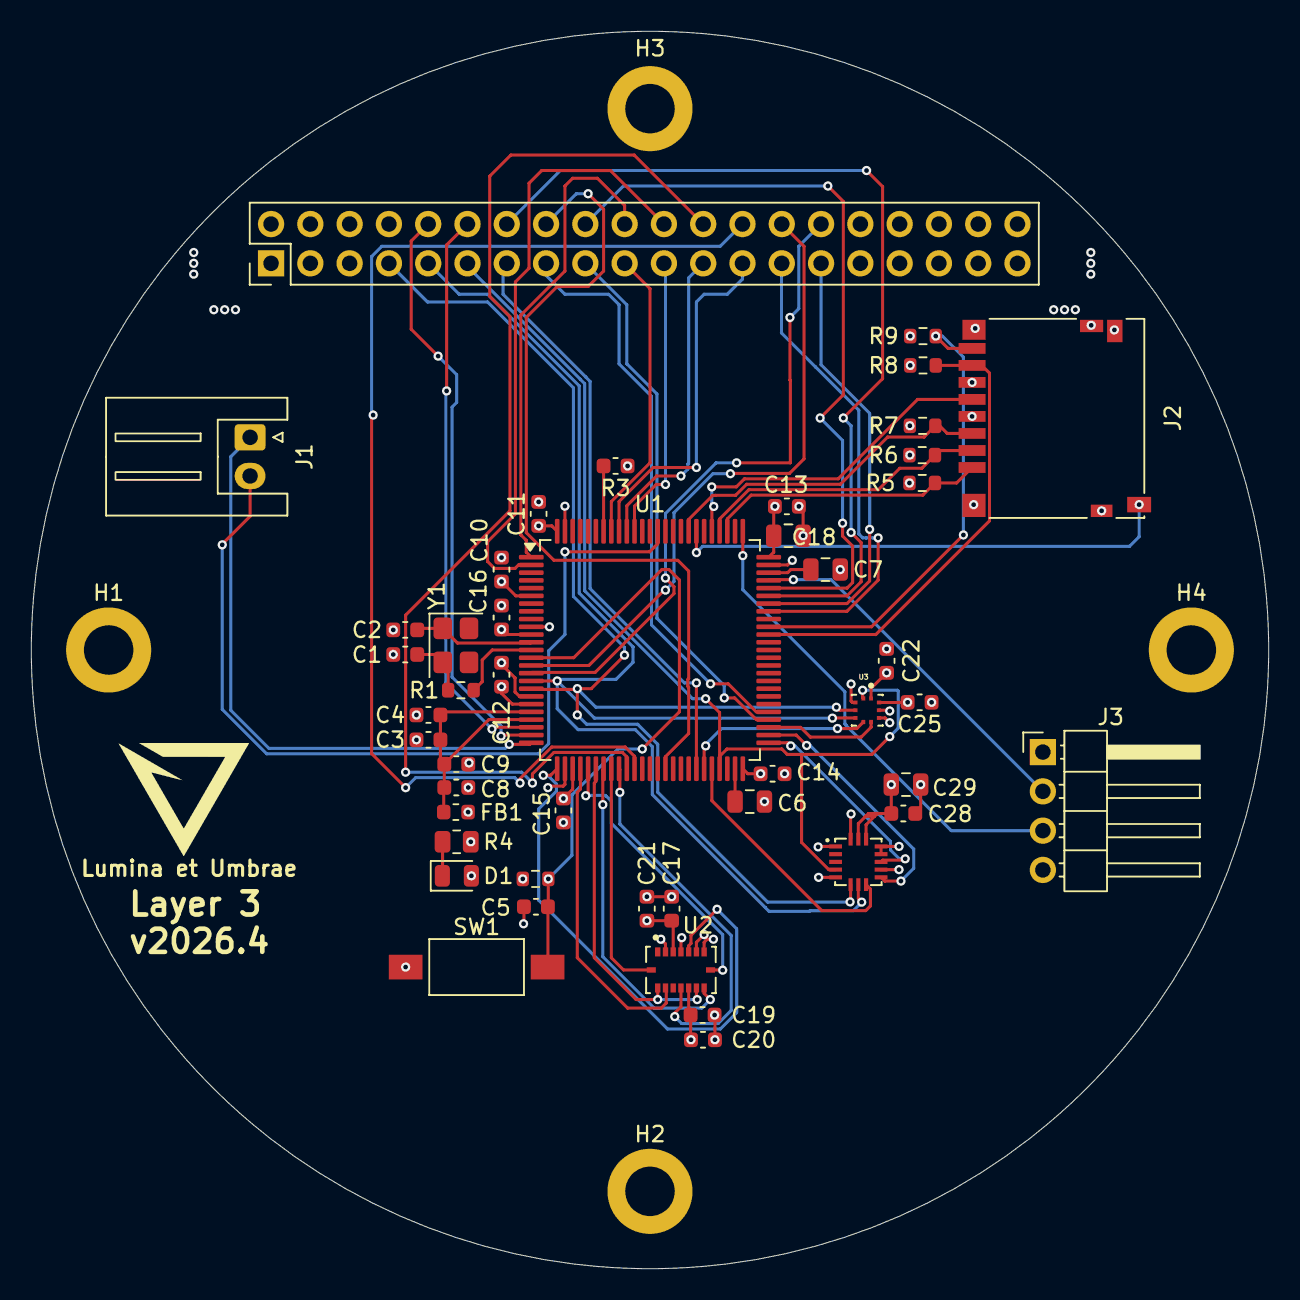
[picture p19: board 台灣盃航電艙中層.kicad_pcb from above]

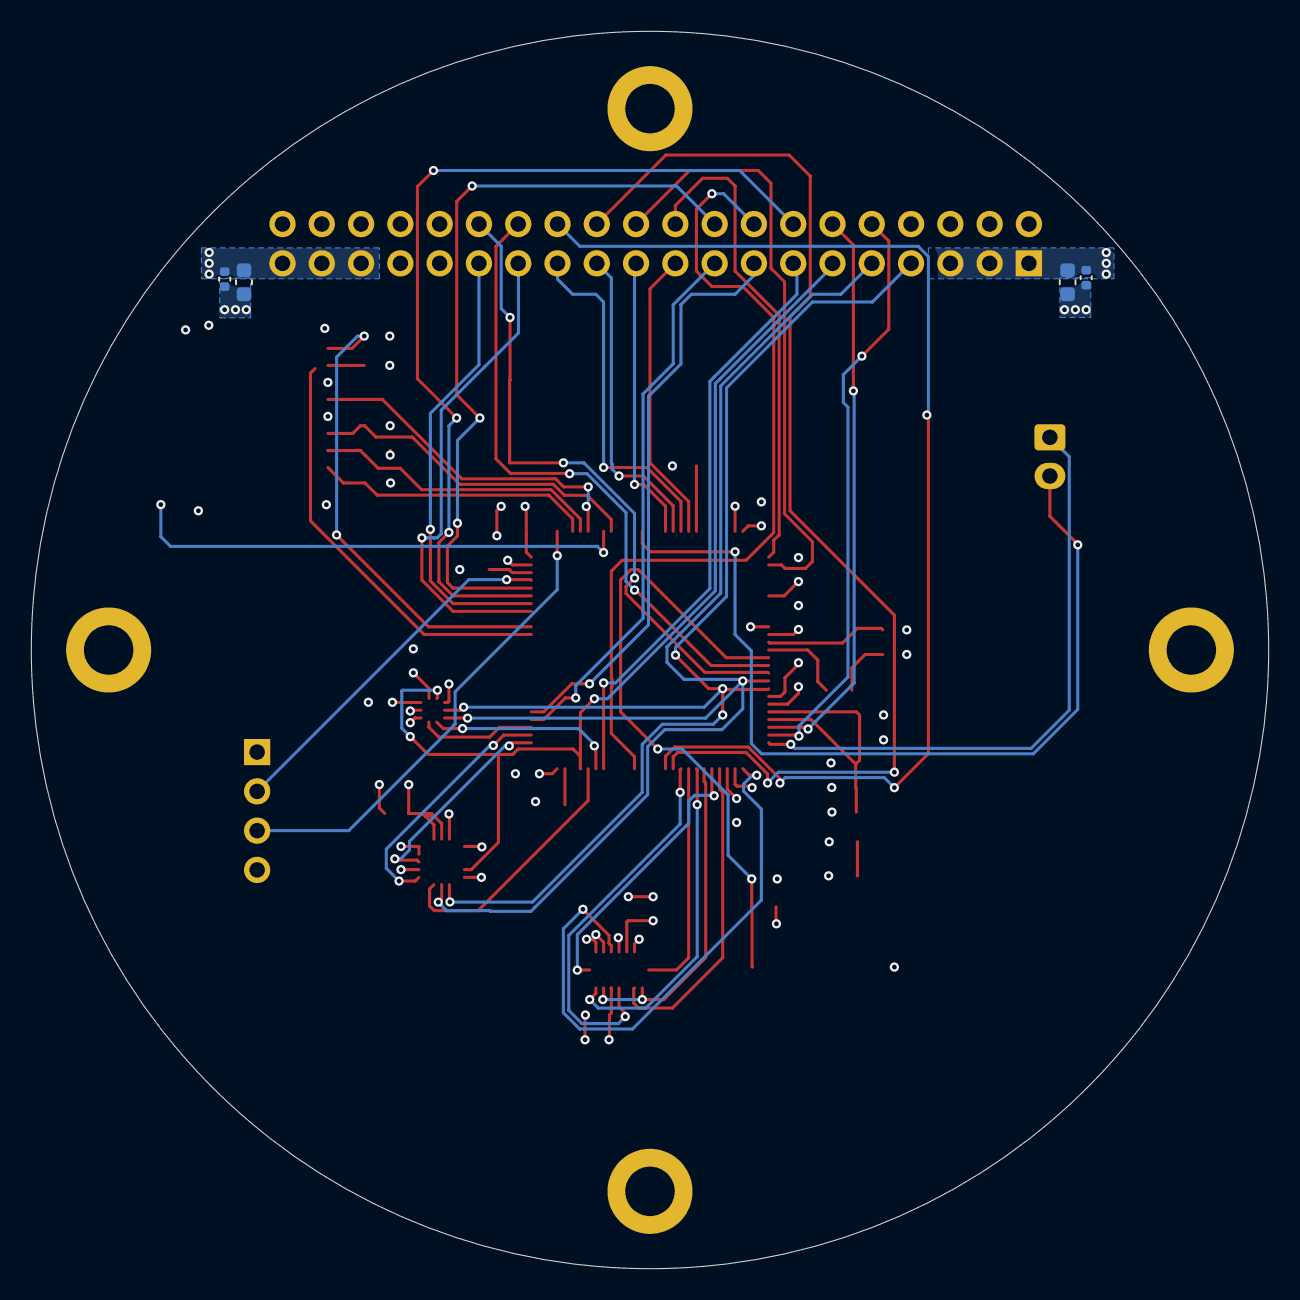
[picture p20: board 台灣盃航電艙中層.kicad_pcb from below]

Board: 4 copper layers, 80.0 x 80.0 mm, 54 parts (4 on the bottom side), 57 nets.
