rat0mu/2026-Rocket-Taiwan-Cup/avionics/hardware/pcb/台灣盃航電艙第1層_聲學實驗/台灣盃航電倉酬載層.kicad_pcb

## KiCad design avionics/hardware/pcb/台灣盃航電艙第1層_聲學實驗/台灣盃航電倉酬載層.kicad_pcb (2026-04-28)

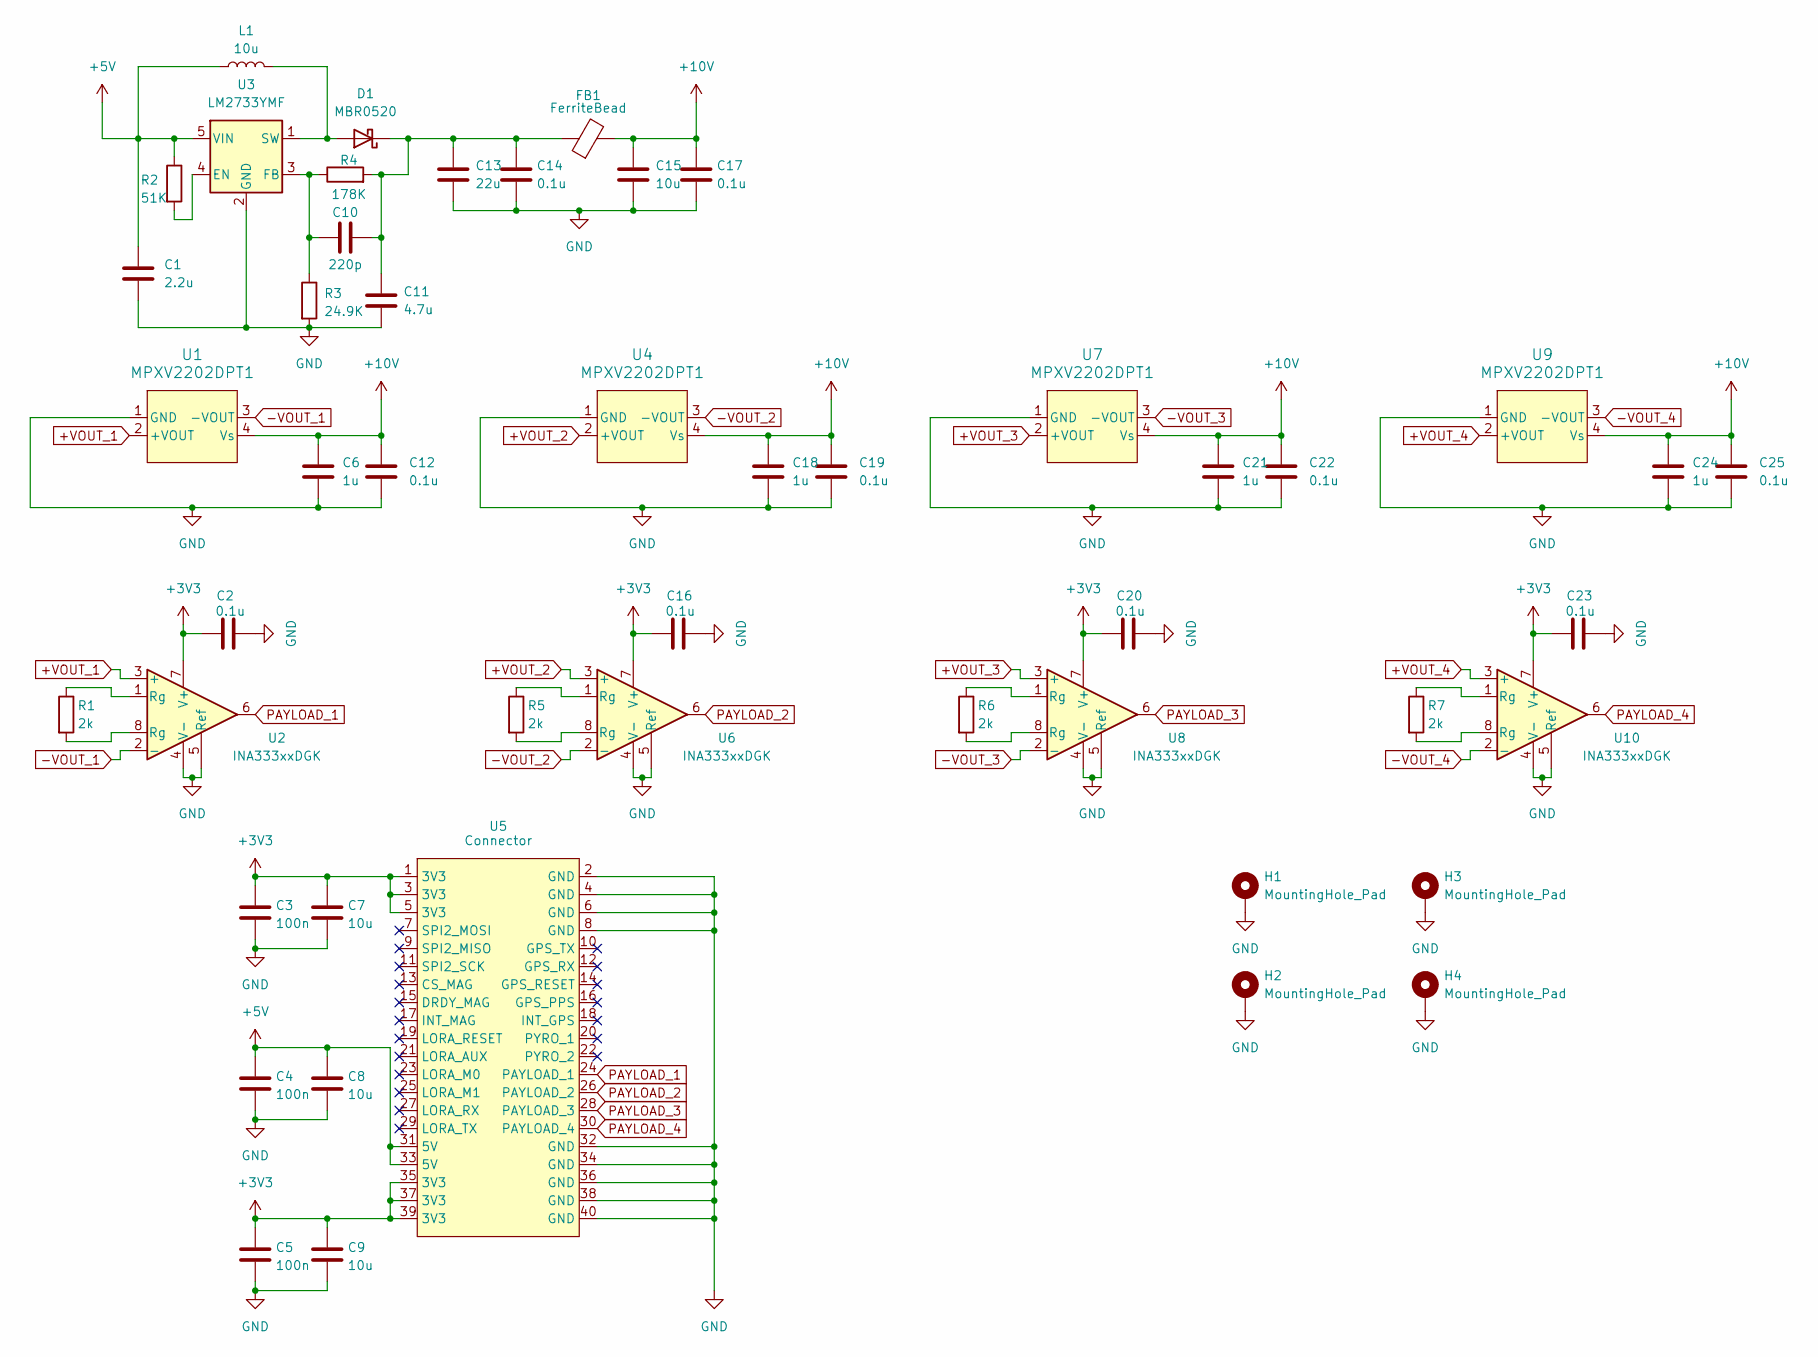
[picture p21: schematic 台灣盃航電倉酬載層.kicad_sch]

Parts:
C1: 2.2u; C_0603_1608Metric
C2, C12, C14, C16, C17, C19, C20, C22, C23, C25: 0.1u; C_0402_1005Metric
C3, C4, C5: 100n; C_0402_1005Metric
C6, C18, C21, C24: 1u; C_0402_1005Metric
C7, C8, C9, C15: 10u; C_0603_1608Metric
C10: 220p; C_0402_1005Metric
C11: 4.7u; C_0603_1608Metric
C13: 22u; C_0805_2012Metric
D1: MBR0520; D_SOD-123
FB1: FerriteBead; L_0603_1608Metric
H1, H2, H3, H4: MountingHole_Pad; MountingHole_2.2mm_M2_DIN965_Pad
L1: 10u; L_1206_3216Metric
R1, R5, R6, R7: 2k; R_0603_1608Metric
R2: 51K; R_0603_1608Metric
R3: 24.9K; R_0603_1608Metric
R4: 178K; R_0603_1608Metric
U1, U4, U7, U9: MPXV2202DPT1; XDCR_MPXV2202DPT1
U2, U6, U8, U10: INA333xxDGK; VSSOP-8_3x3mm_P0.65mm
U3: LM2733YMF; SOT-23-5
U5: Connector; PinHeader_2x20_P2.54mm_Vertical

Connections:
+3V3: C2.1, C3.1, C5.1, C7.1, C9.1, C16.1, C20.1, C23.1, U2.7 (V+), U5.1 (3V3), U5.3 (3V3), U5.5 (3V3), U5.35 (3V3), U5.37 (3V3), U5.39 (3V3), U6.7 (V+), U8.7 (V+), U10.7 (V+)
+5V: C1.1, C4.1, C8.1, L1.1, R2.1, U3.5 (VIN), U5.31 (5V), U5.33 (5V)
+10V: C6.1, C12.1, C15.1, C17.1, C18.1, C19.1, C21.1, C22.1, C24.1, C25.1, FB1.2, U1.4 (Vs), U4.4 (Vs), U7.4 (Vs), U9.4 (Vs)
+VOUT_1: U1.2 (+VOUT), U2.3 (+)
+VOUT_2: U4.2 (+VOUT), U6.3 (+)
+VOUT_3: U7.2 (+VOUT), U8.3 (+)
+VOUT_4: U9.2 (+VOUT), U10.3 (+)
-VOUT_1: U1.3 (-VOUT), U2.2 (-)
-VOUT_2: U4.3 (-VOUT), U6.2 (-)
-VOUT_3: U7.3 (-VOUT), U8.2 (-)
-VOUT_4: U9.3 (-VOUT), U10.2 (-)
GND: C1.2, C2.2, C3.2, C4.2, C5.2, C6.2, C7.2, C8.2, C9.2, C11.2, C12.2, C13.2, C14.2, C15.2, C16.2, C17.2, C18.2, C19.2, C20.2, C21.2, C22.2, C23.2, C24.2, C25.2, H1.1, H2.1, H3.1, H4.1, R3.2, U1.1 (GND), U2.4 (V-), U2.5 (Ref), U3.2 (GND), U4.1 (GND), U5.2 (GND), U5.4 (GND), U5.6 (GND), U5.8 (GND), U5.32 (GND), U5.34 (GND), U5.36 (GND), U5.38 (GND), U5.40 (GND), U6.4 (V-), U6.5 (Ref), U7.1 (GND), U8.4 (V-), U8.5 (Ref), U9.1 (GND), U10.4 (V-), U10.5 (Ref)
unnamed: D1.2 (A), L1.2, U3.1 (SW)
unnamed: C10.2, C11.1, C13.1, C14.1, D1.1 (K), FB1.1, R4.2
unnamed: R1.1, U2.1 (Rg)
unnamed: R1.2, U2.8 (Rg)
unnamed: R5.1, U6.1 (Rg)
unnamed: R5.2, U6.8 (Rg)
unnamed: R6.1, U8.1 (Rg)
unnamed: R6.2, U8.8 (Rg)
unnamed: R7.1, U10.1 (Rg)
unnamed: R7.2, U10.8 (Rg)
unnamed: R2.2, U3.4 (EN)
unnamed: C10.1, R3.1, R4.1, U3.3 (FB)
PAYLOAD_1: U2.6, U5.24 (PAYLOAD_1)
PAYLOAD_2: U5.26 (PAYLOAD_2), U6.6
PAYLOAD_3: U5.28 (PAYLOAD_3), U8.6
PAYLOAD_4: U5.30 (PAYLOAD_4), U10.6

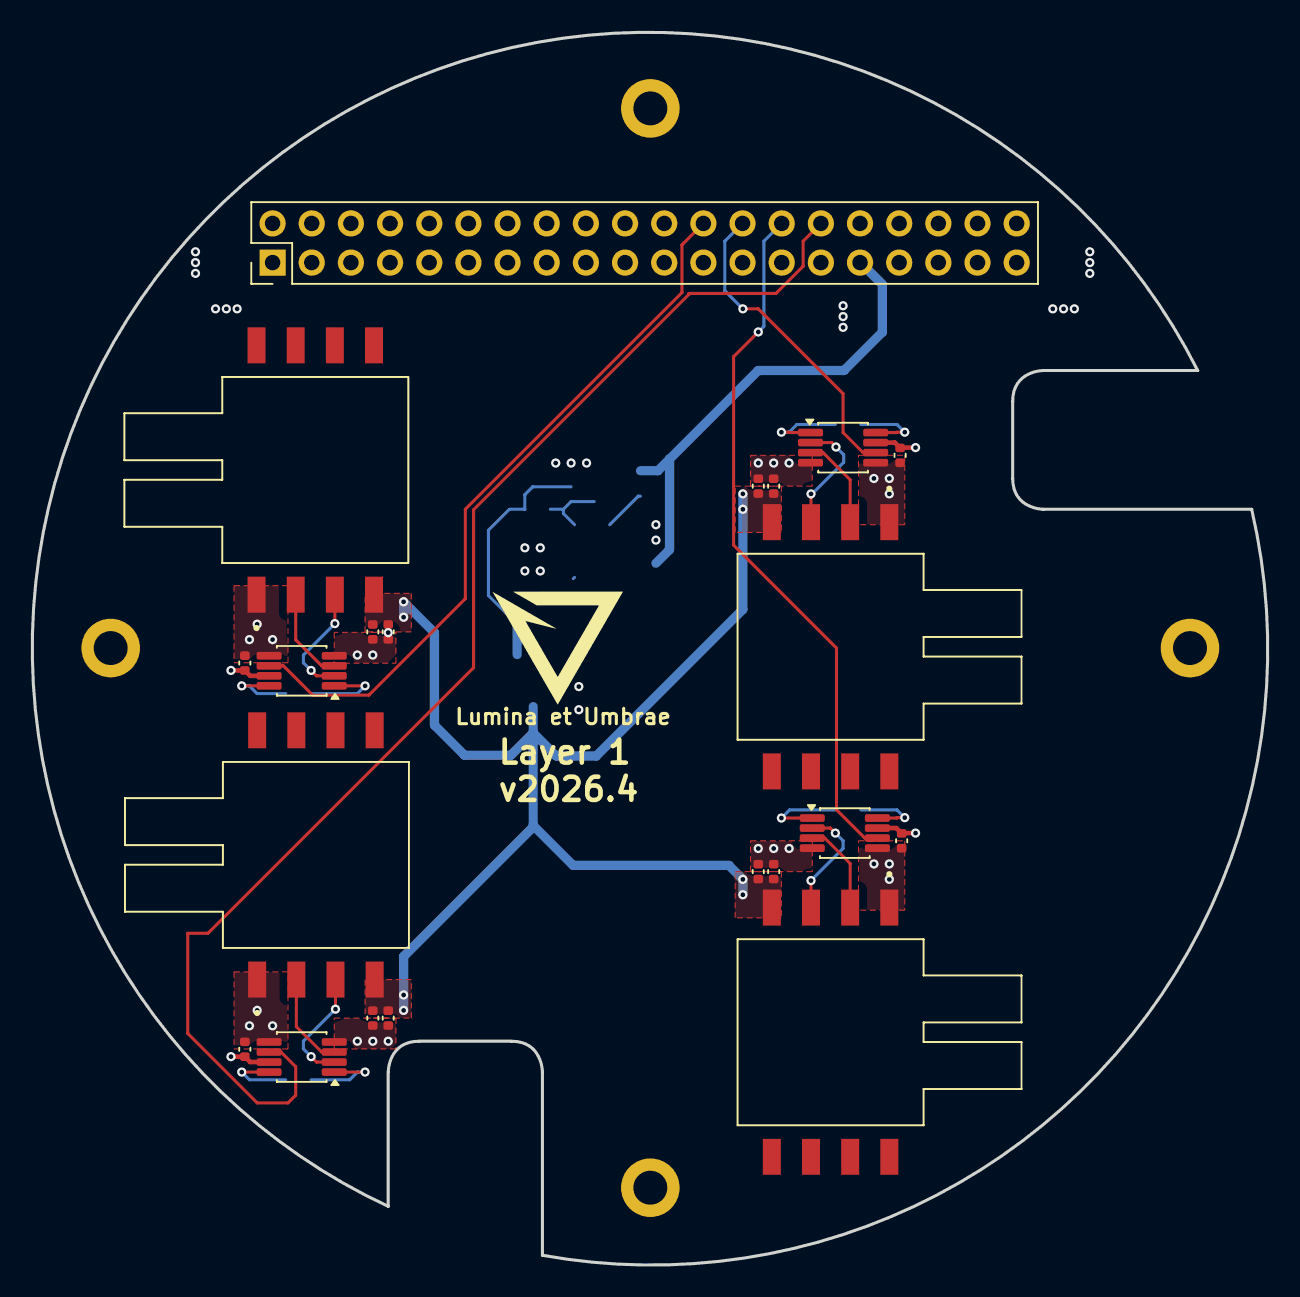
[picture p22: board 台灣盃航電倉酬載層.kicad_pcb from above]

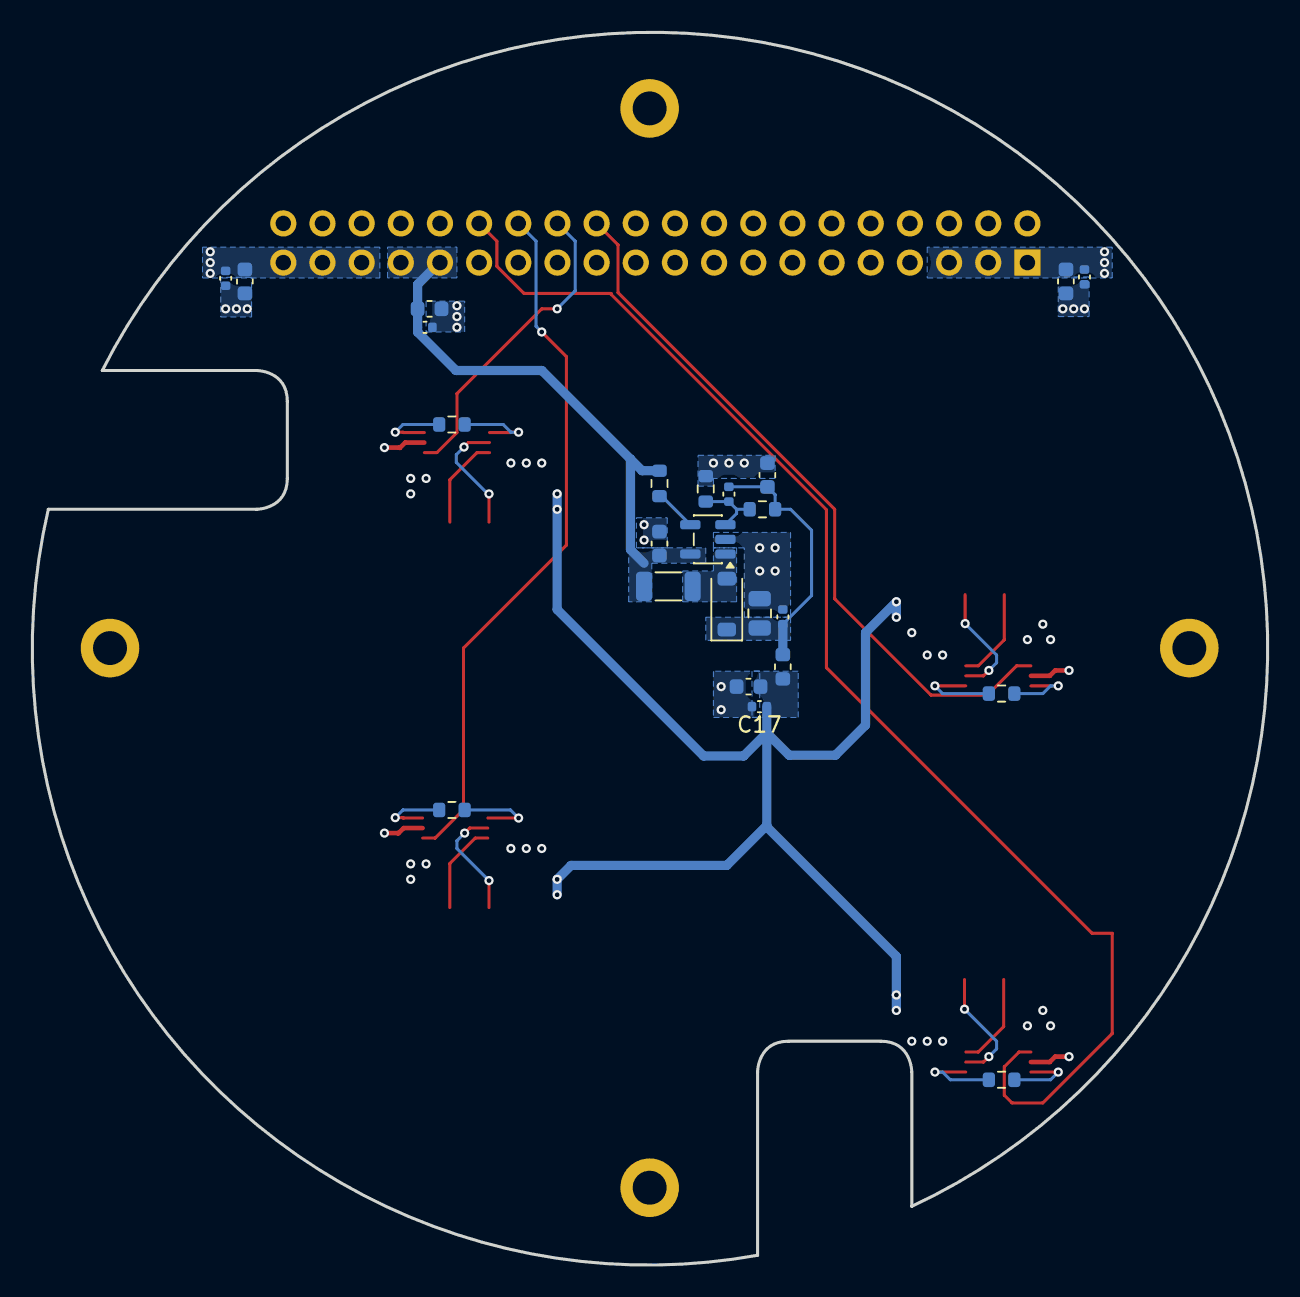
[picture p23: board 台灣盃航電倉酬載層.kicad_pcb from below]

Board: 4 copper layers, 80.1 x 79.9 mm, 49 parts (24 on the bottom side), 28 nets.
