rat0mu/2026-Rocket-Taiwan-Cup/(commit log)

2026-04-17 Add PCB design files
    [台灣盃航電倉上層.kicad_pcb, 台灣盃航電倉上層.kicad_sch]
2026-04-17 Reorganize repository structure and add bilingual README
    [台灣盃航電倉上層.kicad_pcb, 台灣盃航電倉上層.kicad_sch, 台灣盃航電倉下層.kicad_pcb, 台灣盃航電倉下層.kicad_sch, 台灣盃航電倉酬載層.kicad_pcb, 台灣盃航電倉酬載層.kicad_sch, 台灣盃航電艙中層.kicad_pcb, 台灣盃航電艙中層.kicad_sch]
2026-04-17 Reorganize repository into system-level architecture
    [台灣盃航電倉上層.kicad_pcb, 台灣盃航電倉上層.kicad_sch, 台灣盃航電倉下層.kicad_pcb, 台灣盃航電倉下層.kicad_sch, 台灣盃航電倉酬載層.kicad_pcb, 台灣盃航電倉酬載層.kicad_sch, 台灣盃航電艙中層.kicad_pcb, 台灣盃航電艙中層.kicad_sch]
2026-04-17 Track empty subsystem directories with gitkeep
2026-04-18 Adding AGENTS.MD file
    [台灣盃航電倉下層.kicad_pcb, 台灣盃航電倉下層.kicad_sch]
2026-04-19 更新下層PCB原理圖
    [台灣盃航電倉下層.kicad_sch, 台灣盃航電艙中層.kicad_sch]
2026-04-19 Delete avionics/hardware/pcb/台灣盃航電倉下層 directory
    This version has been replaced by version 1.0.
    [台灣盃航電倉下層.kicad_pcb, 台灣盃航電倉下層.kicad_sch]
2026-04-19 Add files via upload
    this is the version 1.0
    [台灣盃航電倉下層.kicad_pcb, 台灣盃航電倉下層.kicad_sch]
2026-04-19 對上層PCB的布局進行了一些修改
    [台灣盃航電倉上層.kicad_pcb, 台灣盃航電倉上層.kicad_sch]
2026-04-20 Add files via upload
    This is V1.1
    add via stitch to increase heat dissipation capacity
    change layer from 4 to 2, and increase thickness to 0.07mm
    resolve the DRC problem
    change the pad connection of the connector
    [台灣盃航電倉下層.kicad_pcb]
2026-04-20 完成上層PCB
    [台灣盃航電倉上層.kicad_pcb]
2026-04-21 更新酬載層內容
    [台灣盃航電倉酬載層.kicad_pcb, 台灣盃航電倉酬載層.kicad_sch]
2026-04-21 V1.2
    change Schottky Diode to nmos
    change the footprint of the 1n5824*2
    change the circuit of the LM2596S-5*2
    change the position of the igition*2
    [台灣盃航電倉下層.kicad_pcb, 台灣盃航電倉下層.kicad_sch]
2026-04-22 V1.0板
    更新原理圖
    layout 完PCB，並且沒有任何DRC錯誤及警告
    增加三個感測器的封裝上去
    [台灣盃航電艙中層.kicad_pcb, 台灣盃航電艙中層.kicad_sch]
2026-04-27 完成所有航電板設計
    [台灣盃航電倉上層.kicad_pcb, 台灣盃航電倉下層.kicad_pcb, 台灣盃航電倉下層.kicad_sch, 台灣盃航電倉次系統.kicad_pcb, 台灣盃航電倉次系統.kicad_sch, 台灣盃航電倉酬載層.kicad_pcb, 台灣盃航電倉酬載層.kicad_sch]
2026-04-28 更改航電PCB檔名
    [台灣盃航電倉上層.kicad_pcb, 台灣盃航電倉上層.kicad_sch, 台灣盃航電倉下層.kicad_pcb, 台灣盃航電倉下層.kicad_sch, 台灣盃航電倉次系統.kicad_pcb, 台灣盃航電倉次系統.kicad_sch, 台灣盃航電倉酬載層.kicad_pcb, 台灣盃航電倉酬載層.kicad_sch]
2026-04-28 上傳新的連接器
    [First_Layer_bom.csv, First_Layer_designators.csv, First_Layer_positions.csv, 台灣盃航電倉上層.kicad_pcb, 台灣盃航電倉上層.kicad_sch, 台灣盃航電倉下層.kicad_sch, 台灣盃航電倉酬載層.kicad_pcb, 台灣盃航電倉酬載層.kicad_sch]
2026-04-28 將第一至三層連接器修改成PC104規格，第四層還未進行
    [First_Layer_bom.csv, First_Layer_designators.csv, First_Layer_positions.csv, 台灣盃航電倉上層.kicad_pcb, 台灣盃航電倉上層.kicad_sch, 台灣盃航電倉酬載層.kicad_pcb, 台灣盃航電倉酬載層.kicad_sch, 台灣盃航電艙中層.kicad_pcb]
2026-04-28 刪除Propulsion資料夾
2026-04-29 Add files via upload
    change schematics
    [台灣盃航電倉下層.kicad_pcb, 台灣盃航電倉下層.kicad_sch]
2026-04-29 更新第4,5層PCB
    [First_Layer_bom.csv, First_Layer_designators.csv, First_Layer_positions.csv, bom.csv, designators.csv, positions.csv, 台灣盃航電倉上層.kicad_pcb, 台灣盃航電倉上層.kicad_sch]
2026-04-30 更新PCB圖，記得要直接下載PCB檔
    [台灣盃航電倉下層.kicad_pcb, 台灣盃航電倉下層.kicad_sch]
2026-05-03 完成PCB最終設計
    [bom.csv, designators.csv, positions.csv, 台灣盃航電倉上層.kicad_pcb, 台灣盃航電倉上層.kicad_sch, 台灣盃航電倉下層.kicad_pcb, 台灣盃航電倉下層.kicad_sch, 台灣盃航電倉次系統.kicad_pcb]
2026-05-14 航電倉第二層
    [BatteryHolder_Keystone_3000_1x12mm.sldprt, C_0201_0603Metric.sldprt, C_0402_1005Metric.sldprt, C_0603_1608Metric.sldprt, C_0805_2012Metric.sldprt, D_SOD-123.sldprt, LGA-12_2x2mm_P0.5mm.sldprt, L_0603_1608Metric.sldprt]
2026-05-14 航電倉第一層
    [C_0402_1005Metric.sldprt, C_0603_1608Metric.sldprt, C_0805_2012Metric.sldprt, D_SOD-123.sldprt, L_0603_1608Metric.sldprt, L_1206_3216Metric.sldprt, PinHeader_2x20_P2.54mm_Vertical.sldprt, R_0603_1608Metric.sldprt]
2026-05-14 航電倉第三層
    [C_0402_1005Metric.sldprt, C_0603_1608Metric.sldprt, C_0805_2012Metric.sldprt, Crystal_SMD_3225-4Pin_3.2x2.5mm.sldprt, JST_XH_S2B-XH-A_1x02_P2.50mm_Horizontal.sldprt, LED_0805_2012Metric.sldprt, LQFP-100_14x14mm_P0.5mm.sldprt, L_0603_1608Metric.sldprt]
2026-05-14 航電倉第四層
    [CP_Elec_10x10.sldprt, CP_Elec_8x10.sldprt, C_0603_1608Metric.sldprt, C_0805_2012Metric.sldprt, D_SMC.sldprt, D_SOD-123.sldprt, JST_XH_S2B-XH-A_1x02_P2.50mm_Horizontal.sldprt, JST_XH_S6B-XH-A_1x06_P2.50mm_Horizontal.sldprt]
2026-05-14 航電倉第五層
    [BatteryHolder_Keystone_3000_1x12mm.sldprt, C_0201_0603Metric.sldprt, C_0402_1005Metric.sldprt, C_0603_1608Metric.sldprt, C_0805_2012Metric.sldprt, Crystal_SMD_3225-4Pin_3.2x2.5mm.sldprt, D_SOD-123.sldprt, JST_XH_S2B-XH-A_1x02_P2.50mm_Horizontal.sldprt]
2026-05-14 剩餘的零組件及支架模型
    [avionic_bay.SLDASM, cylinder15mm.SLDPRT, support cylinder.SLDPRT]
