rat0mu/2026-Rocket-Taiwan-Cup/(notices)

Notices in the files:
avionics/firmware/primary_fc/cubemx/raw/Core/Inc/main.h:
Copyright (c) 2026 STMicroelectronics.
All rights reserved.
This software is licensed under terms that can be found in the LICENSE file
